dueber-dev/SIMON-Sistema-de-Monitoreo-Neuronal/cad/caja_pcb/README.md

# Caja de la PCB de SIMON

Caja con tapa para la PCB, en SolidWorks 2025 (piezas nativas con árbol y cotas). Pensada
para imprimirse en una **Flashforge Adventurer 5M con boquilla de 0.4 mm**, sin soportes.

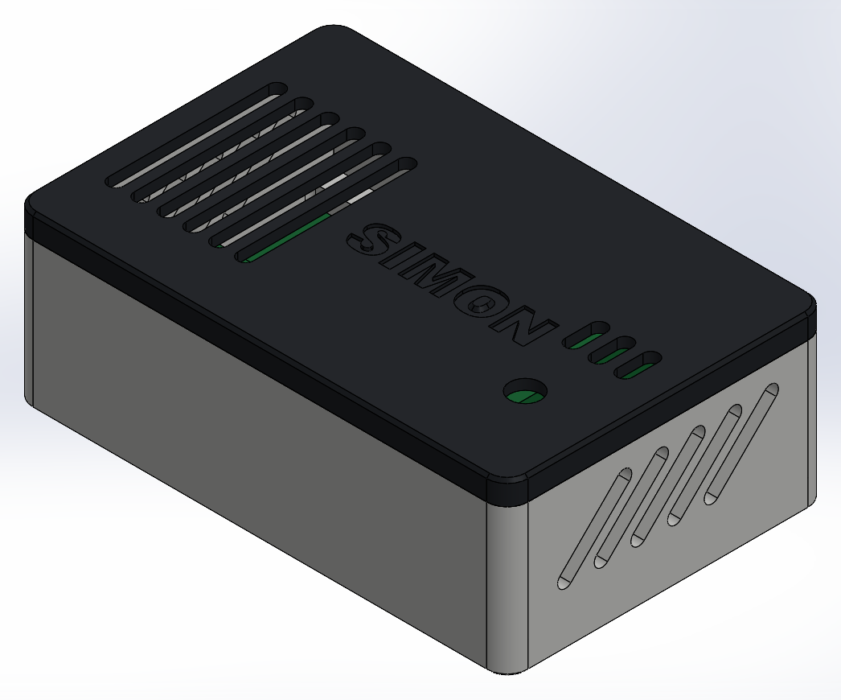
[picture p14: cad/caja_pcb/capturas/ensamble_cerrado.png]
cerrada

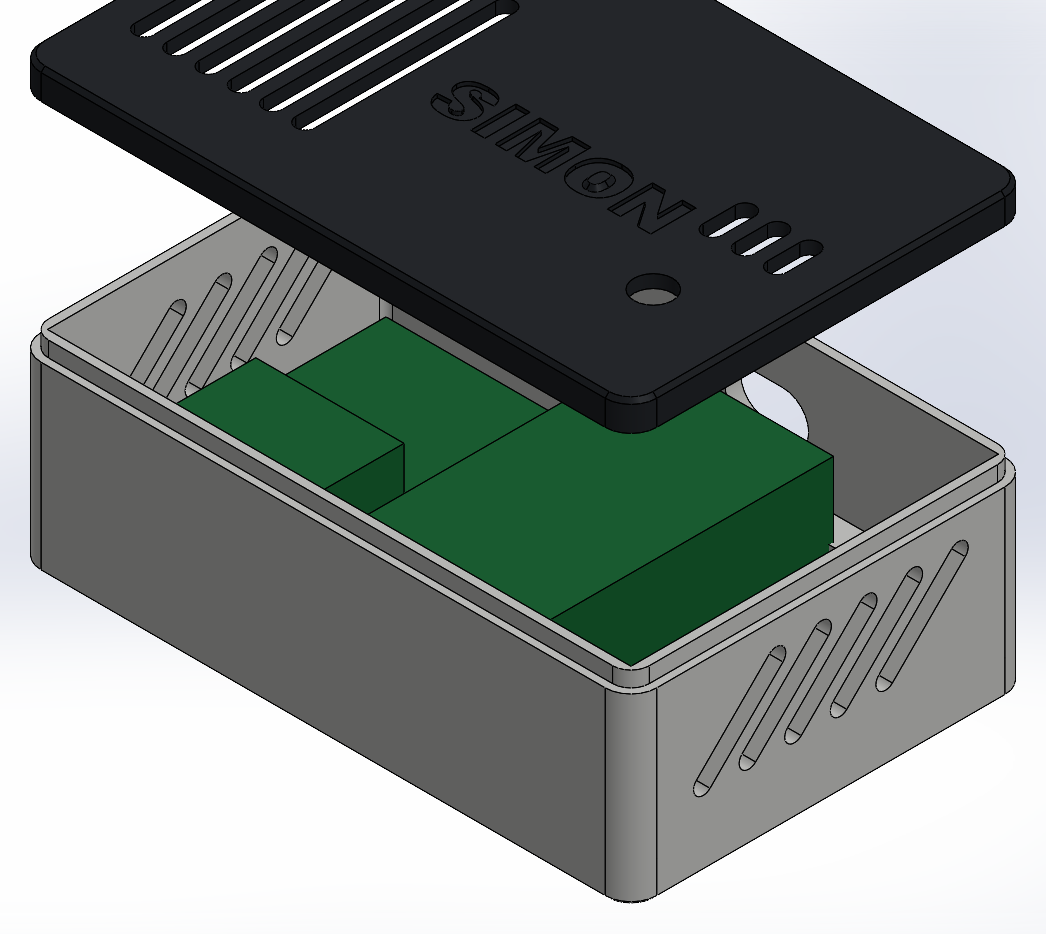
[picture p15: cad/caja_pcb/capturas/ensamble_abierto.png]
abierta


## Medidas

| | |
|---|---|
| Exterior | 95.5 × 62 × 33 mm (caja 30.9 + tapa) |
| Hueco de la PCB | **90.5 × 52.5 mm** (placa real + ~0.3 de tolerancia), hasta 2.5 mm sobre la PCB |
| Interior arriba | **90.5 × 57 mm**: el ESP32 sobresale por el lado del USB, así que los 4.5 mm de más van todos hacia la pared trasera (`ANCHO_ESP`) |
| Paredes | 2.5 mm |
| Piso y tapa | 2.0 mm (10 capas de 0.2; ahorra filamento sin perder rigidez) |
| PCB | apoyada 4 mm sobre el piso (las soldaduras van abajo) |
| Espacio sobre la PCB | 23.4 mm (el INA219 sobre su header mide ~20 mm) |
| Material | 43.6 cm³ macizo: caja 32.5 + tapa 11.1 (≈ 54 g de PLA si fuera 100 % lleno) |

## Cierre labio / escalón (lip/groove)

- **Caja:** la franja interior de la pared (1.35 mm, unas 3 líneas de 0.42) sube 2.4 mm sobre el borde. Es el **labio**.
- **Tapa:** su borde exterior (1.05 mm) baja 2.5 mm y abraza el labio. Es el **escalón**; por fuera queda al ras con la caja.
- **Holgura:** 0.1 mm por lado. Con 0.2 la primera impresión quedó un poco suelta, así que el labio creció 0.1 por lado. Si ahora queda muy duro, sube `HOLG_LG` (y baja `LABIO_W` lo mismo) en `caja_simon.py` y regenera.

La API de SolidWorks no permite crear la operación nativa *Lip/Groove*, así que está
modelada como dos operaciones con nombre: `Labio_lip` en la caja y `Escalon_groove` en la tapa.
Si prefieres la operación nativa de SolidWorks, usa la variante plana:

```bash
python caja_simon.py --plano
```

Genera `caja_simon_plano.SLDASM`: la tapa apoyada directo sobre la caja, sin labio, igual
que la primera caja. Ahí aplicas *Insertar → Operaciones de sujeción → Labio/Ranura*.

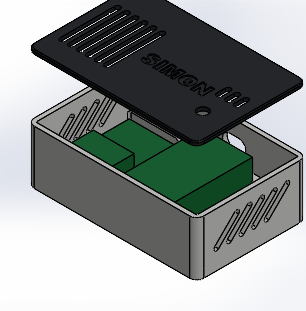
[picture p16: cad/caja_pcb/capturas/ensamble_abierto_plano.png]
plana


## Detalles de diseño

- **La PCB se ubica con las paredes**: no lleva agujeros. Descansa en 4 apoyos de esquina. La tapa no lleva postes, así que nada la aprieta desde arriba; si se mueve, fíjala a los apoyos con una gota de silicón caliente o cinta doble cara.
- **Alivios de Ø2 en las esquinas interiores:** la impresora redondea las esquinas y la placa, que es cuadrada, se trabaría. Con el alivio entra libre.
- **Pared trasera:** salida para el **USB del ESP32** y para el **cable del panel** (bornera J1). El frente queda limpio.
- **Ventilación:**
  - **Todas las ranuras (base y tapa) miden 3 mm de ancho**, así pasa un jumper dupont (2.54 mm) por ellas. Entre ranuras quedan 2 mm de material. Las dos medidas son `RANURA` y `NERVIO` en `caja_simon.py`.
  - **Rejilla diagonal en el piso:** 7 ranuras de 3 × 44 mm a 45°. El aire entra por abajo y sale por la tapa (efecto chimenea). Se imprimen como huecos en las primeras capas, sin soporte.
  - **5 ranuras diagonales de 3 × 19 mm a 45° en cada pared corta.** El borde de arriba de cada ranura queda a 45°, que la impresora hace sin soporte.
  - Ranuras en la tapa sobre las resistencias de carga y el INA219, que son lo que más calienta.
  - Tres ranuras junto al LM35.
  - Para que la rejilla del piso respire, pégale **4 patitas de hule** (bumpers de 2–3 mm) abajo. Si la caja queda pegada a la mesa, el piso casi no ventila.

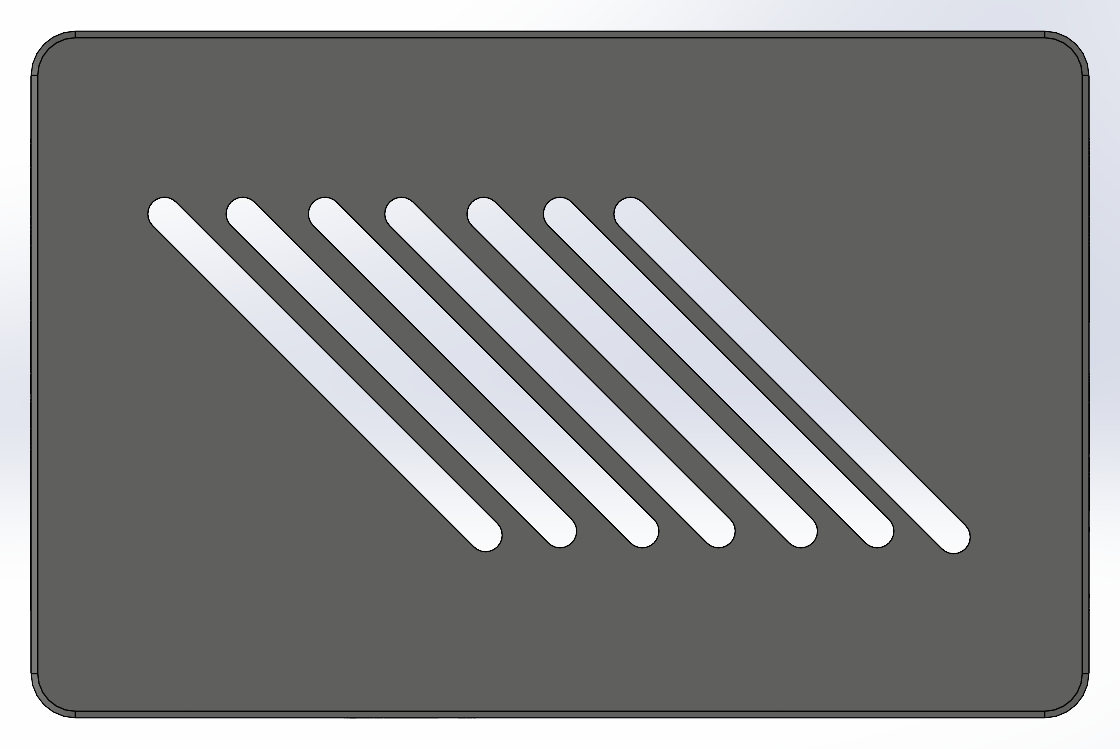
[picture p17: cad/caja_pcb/capturas/caja_simon_base_abajo.png]
piso
  
- **Ventana de Ø6 sobre la LDR:** sin ella, la LDR quedaría a oscuras dentro de la caja.
- **"SIMON" en bajo relieve** (0.6 mm) en la tapa. Como esa cara va contra la cama, sale nítido.
- **Chaflán de 0.6 mm** en los bordes que tocan la cama, contra la pata de elefante. No lleva redondeos abajo porque se imprimen mal.

## Imprimir (Flashforge Orca, perfil *Adventurer 5M 0.4 Nozzle*)

Los STL de `stl/` ya vienen orientados: caja con el piso abajo, tapa con su cara plana abajo
y el escalón hacia arriba. Solo hay que importarlos.

| Ajuste | Valor |
|---|---|
| Material | PLA (o PETG) |
| Altura de capa | 0.2 mm |
| Perímetros (wall loops) | 3: con 2.5 mm la pared sale maciza y el labio sale como perímetros |
| Capas superiores / inferiores | 4 / 4 |
| Relleno | 15 % giroide (solo afecta piso y tapa) |
| Soportes | ninguno |
| Costura (seam) | alineada atrás, para que quede en la pared del USB |
| Compensación pata de elefante | 0.1 mm |

El slicer dará los gramos exactos. Con estos ajustes debería quedar por debajo del valor macizo.

**Prueba de ajuste:** antes de imprimir todo, en Orca puedes cortar (*Cut*) los 5 mm superiores
de la caja e imprimirlos junto con la tapa, que solo mide 4.5 mm de alto. Así pruebas el labio rápido.

## Supuestos a confirmar

- **ESP32 montado sobre headers hembra de 8.5 mm.** De eso sale la altura de la salida USB. Si lo sueldan directo, la salida queda alta: ajusta `usb_y` en `caja_simon.py`.
- **Placa recortada con el diseño de 88 × 50 centrado** dentro de los 90.5 × 52.5. Las salidas tienen holgura (13 × 8 y 12 × 7) para absorber 1 mm de diferencia.

## Archivos

| Archivo | Qué es |
|---|---|
| `caja_simon.SLDASM` | Ensamble (caja + PCB de referencia + tapa) |
| `caja_simon_base.SLDPRT`, `caja_simon_tapa.SLDPRT` | Las piezas |
| `*_plano.*` | Variante sin labio, para el Lip/Groove nativo |
| `stl/` | Listos para el slicer |
| `caja_simon.STEP` | Para abrir en otro CAD |
| `caja_simon.py` | Medidas y construcción; se regenera con `python caja_simon.py` |
