dueber-dev/SIMON-Sistema-de-Monitoreo-Neuronal/design/index.html

# Buenos días, equipo SIMON ☀️

Panel solar · Sesión v7 · --:--:--

—

1 min 5 min 15 min Todo

## Cámara de inspección visual (ESP32-CAM) i

Soporte frontal a 50° En vivo http://192.168.4.2:81/stream

Actualizar foto

Conectando a ESP32-CAM…

Esperando señal de video o foto desde la cámara

## Potencia medida vs teórica i

MedidaTeórica (ficha técnica)mW · últimos 5 min

Medida / teórica —

Sesión en curso Energía generada en la sesión i

0,00Wh

00:00:00Tiempo activo

—Pico de potencia (mW)

## Eficiencia real vs nominal i

RealNominalUmbral de mantenimiento

Real — %

## Temperatura del panel i

°CUmbral de alerta

## Voltaje i

V · bus del INA219

## Corriente i

mA · INA219

## Potencia vs irradiancia i

mW vs W/m² · cada punto = 1 s · ajuste cuadrático

### Panel monocristalino

Prototipo · laboratorio

1,0 WNominal

9,1 %η nominal

110cm² área

#### Rendimiento vs nominal i

—

## Estado del sistema

i

## Sesiones

Ver todas

## Eficiencia predicha i

Modelo de demostración

— %

Calculando…

Ver predicción

### Fondo

Campo solar Atardecer Noche + Tu imagen

Desenfoque 0 px

Atenuar fondo 10 %
