dueber-dev/SIMON-Sistema-de-Monitoreo-Neuronal/design/maqueta-en-vivo.html

# Buenos días, equipo SIMON ☀️

Panel solar de prueba · Sesión v7 · --:--:--

ESP32 conectado · 1 Hz · 192.168.4.1

1 min 5 min 15 min Todo

## Potencia en vivo

mW · últimos 5 min

Pico — mW

Sesión en curso Energía generada en la sesión

0.00Wh

00:00:00Tiempo activo

0Muestras guardadas

## Voltaje

V · bus del INA219

## Corriente

mA · INA219

## Potencia vs irradiancia

Cada punto = 1 s · ajuste lineal

### Panel monocristalino

Prototipo · laboratorio

1.0 WNominal

6.0 VVoc

110cm² área

#### Rendimiento actual

Potencia instantánea respecto a la nominal (1.0 W)

## Estado del sistema

## Sesiones

Ver todas

- datos_panel_v7.csvHoy · en cursoEn vivo
- datos_panel_v6.csvAyer · 42 min · 2 518 muestras3.1 Wh
- datos_panel_v5.csv3 oct · 1 h 05 min · 3 912 muestras4.6 Wh

## Eficiencia predicha

Modelo de machine learning

— %

Modelo no cargado. Cuando esté entrenado, aquí se compara la eficiencia esperada con la real.

Conectar modelo (siguiente fase)

### Fondo

Campo solar Atardecer Noche + Tu imagen

Desenfoque 0 px

Atenuar fondo 10 %
