dueber-dev/SIMON-Sistema-de-Monitoreo-Neuronal/cad/caja_pcb/capturas/caja_simon_tapa.png

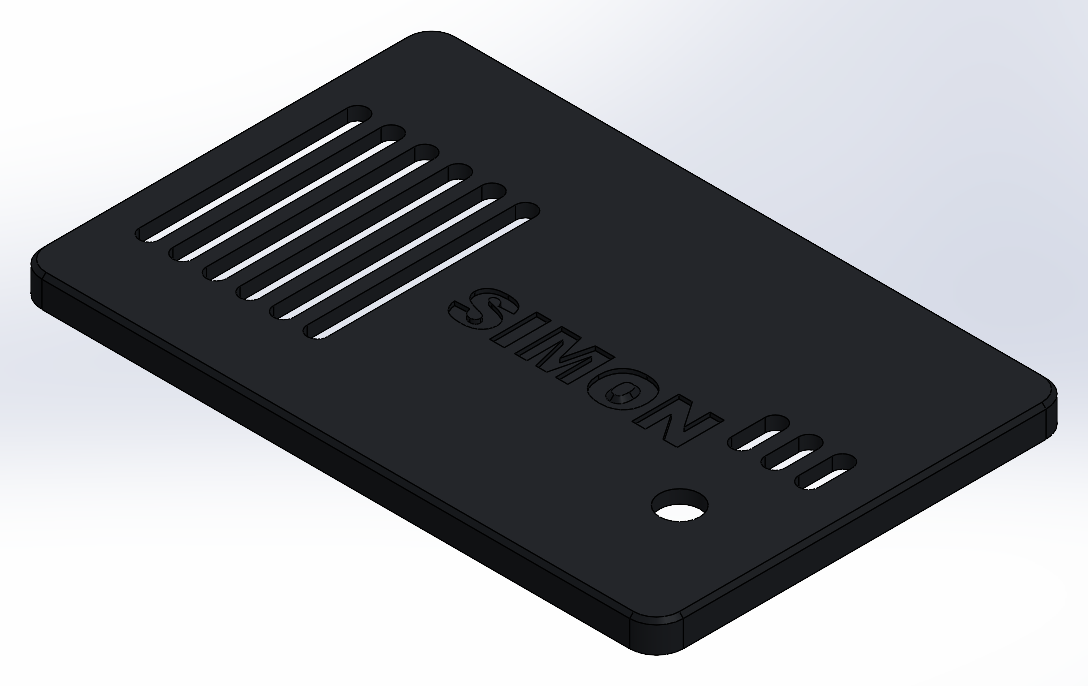
cad/caja_pcb/capturas/caja_simon_tapa.png
