dueber-dev/SIMON-Sistema-de-Monitoreo-Neuronal/cad/capturas/base_webcam.png

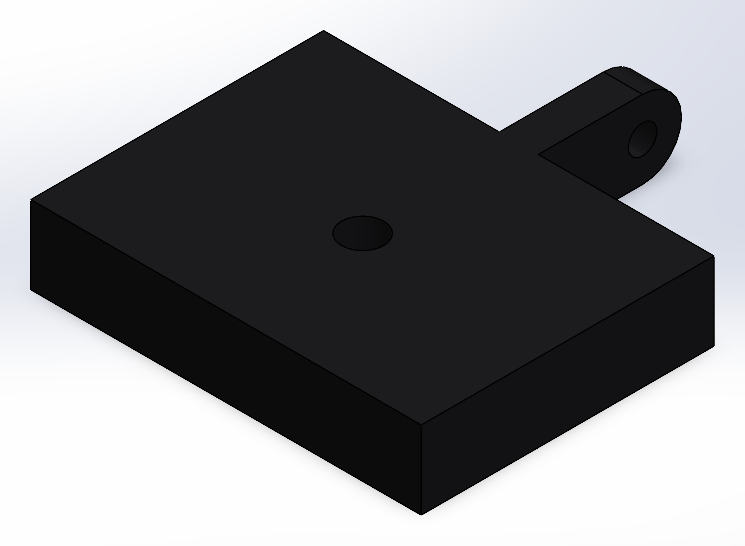
cad/capturas/base_webcam.png
