dueber-dev/SIMON-Sistema-de-Monitoreo-Neuronal/cad/capturas/base_y_torres.png

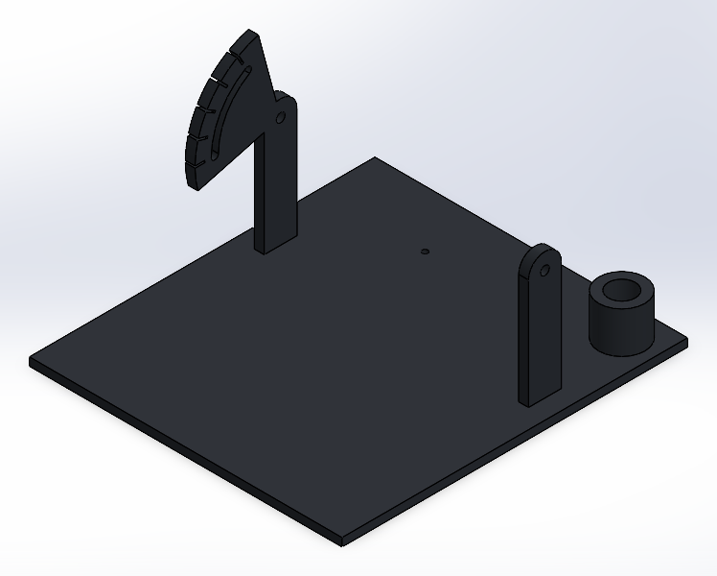
cad/capturas/base_y_torres.png
