dueber-dev/SIMON-Sistema-de-Monitoreo-Neuronal/cad/capturas/brazo_camara.png

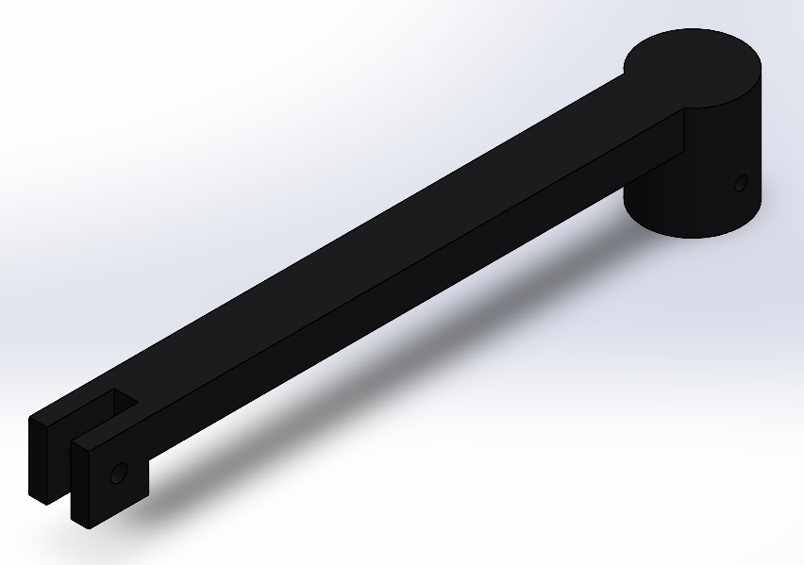
cad/capturas/brazo_camara.png
