dueber-dev/SIMON-Sistema-de-Monitoreo-Neuronal/cad/capturas/caja_pcb.png

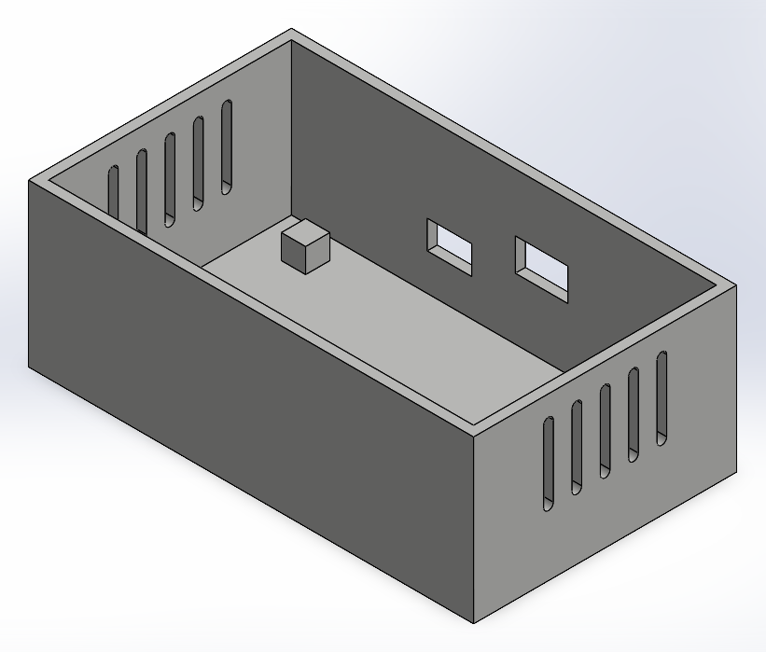
cad/capturas/caja_pcb.png
