dueber-dev/SIMON-Sistema-de-Monitoreo-Neuronal/cad/capturas/marco_panel.png

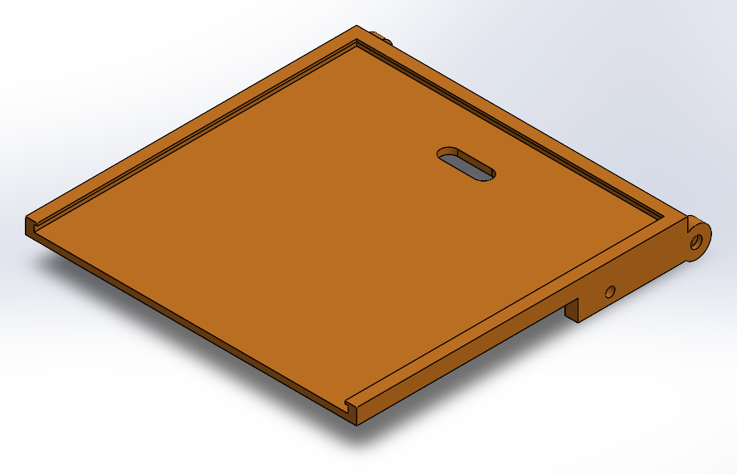
cad/capturas/marco_panel.png
