dueber-dev/SIMON-Sistema-de-Monitoreo-Neuronal/cad/capturas/perilla_M4.png

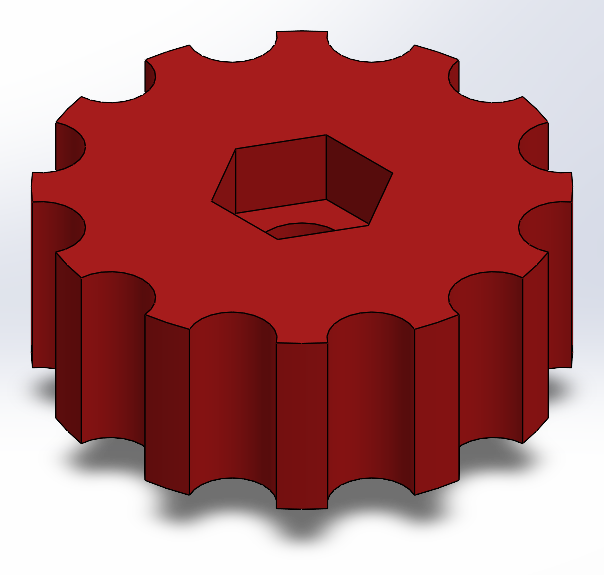
cad/capturas/perilla_M4.png
