dueber-dev/SIMON-Sistema-de-Monitoreo-Neuronal/cad/capturas/ref_panel_solar.png

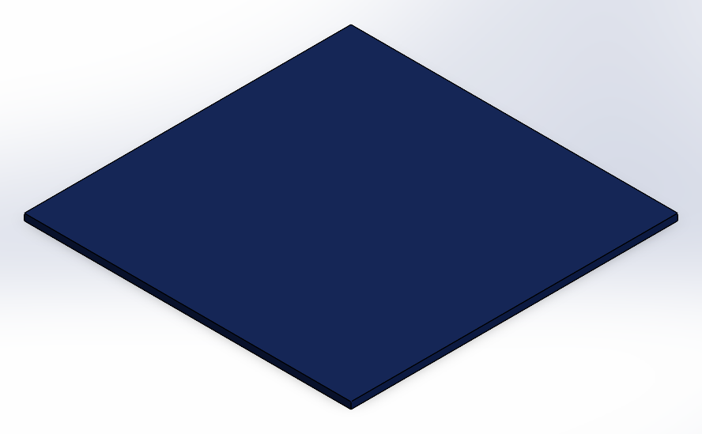
cad/capturas/ref_panel_solar.png
