dueber-dev/SIMON-Sistema-de-Monitoreo-Neuronal/cad/capturas/ref_pcb_simon.png

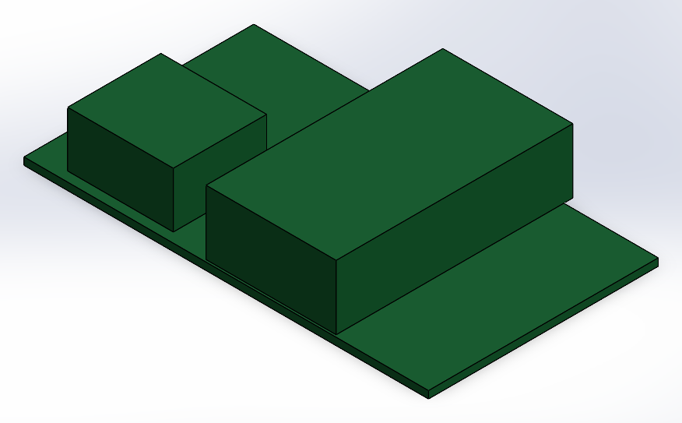
cad/capturas/ref_pcb_simon.png
