dueber-dev/SIMON-Sistema-de-Monitoreo-Neuronal/cad/capturas/tapa_caja.png

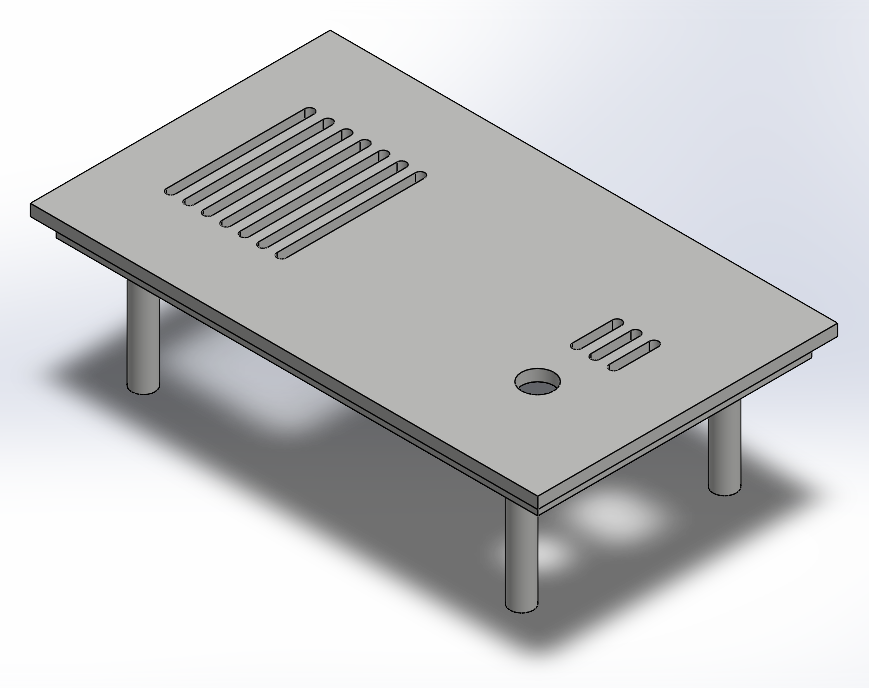
cad/capturas/tapa_caja.png
