dueber-dev/SIMON-Sistema-de-Monitoreo-Neuronal/cad/modulo_panel/capturas/camara_frente.png

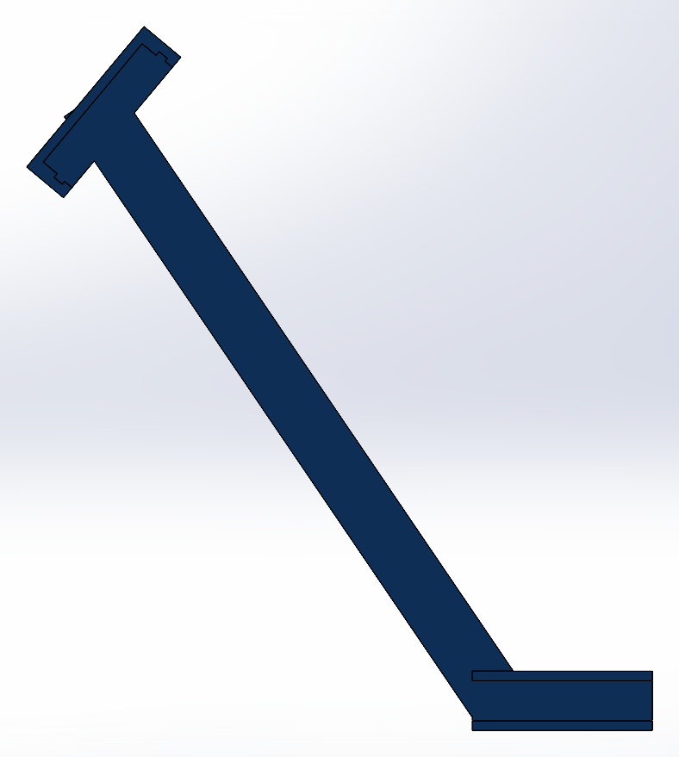
cad/modulo_panel/capturas/camara_frente.png
