dueber-dev/SIMON-Sistema-de-Monitoreo-Neuronal/cad/modulo_panel/capturas/camara_iso.png

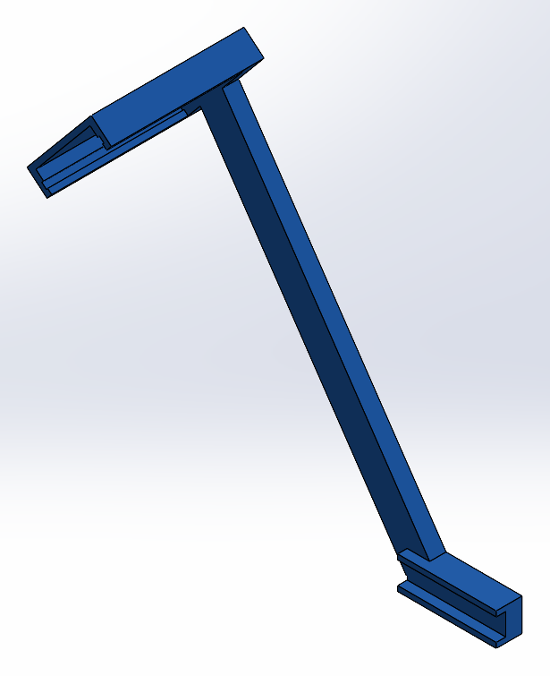
cad/modulo_panel/capturas/camara_iso.png
