dueber-dev/SIMON-Sistema-de-Monitoreo-Neuronal/cad/modulo_panel/capturas/camara_modulo_lado.png

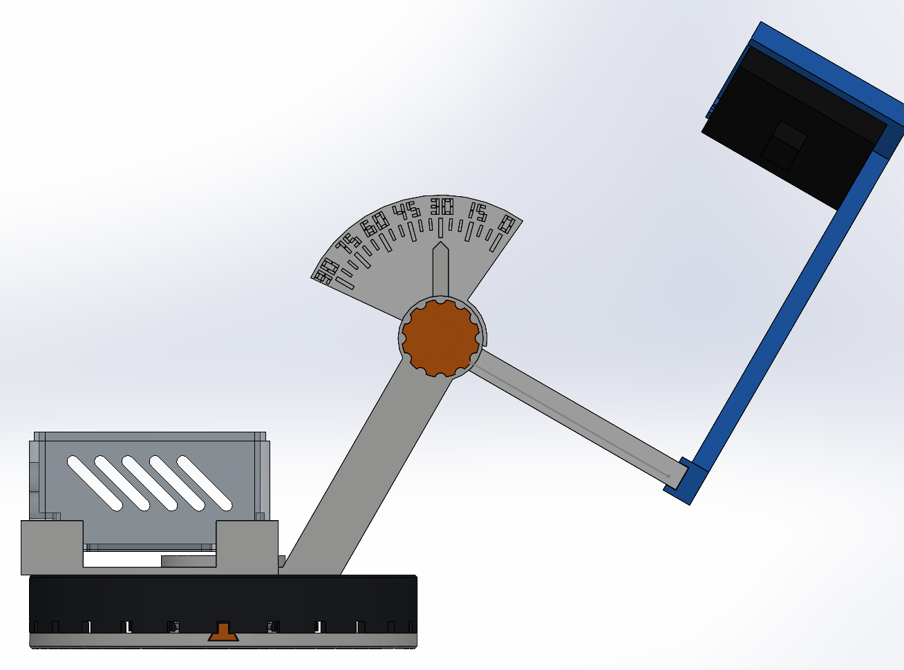
cad/modulo_panel/capturas/camara_modulo_lado.png
