dueber-dev/SIMON-Sistema-de-Monitoreo-Neuronal/cad/modulo_panel/capturas/marco_atras.png

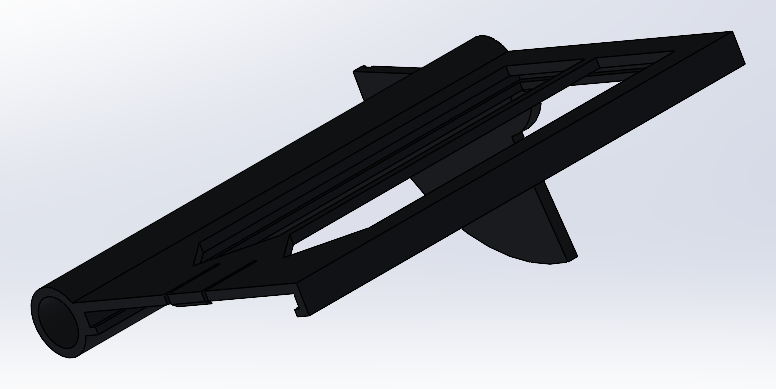
cad/modulo_panel/capturas/marco_atras.png
