dueber-dev/SIMON-Sistema-de-Monitoreo-Neuronal/cad/modulo_panel/capturas/modulo_sin_caja.png

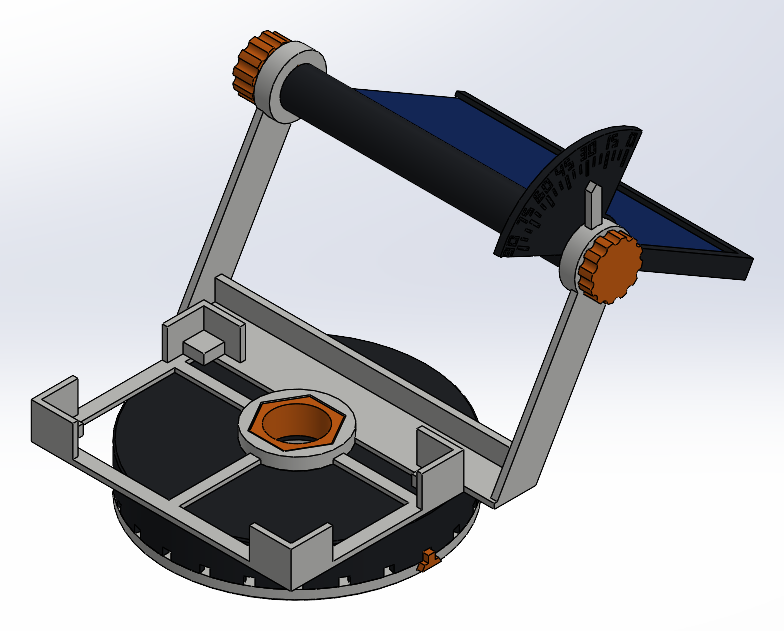
cad/modulo_panel/capturas/modulo_sin_caja.png
