dueber-dev/SIMON-Sistema-de-Monitoreo-Neuronal/cad/turntable/capturas/corte_frente.png

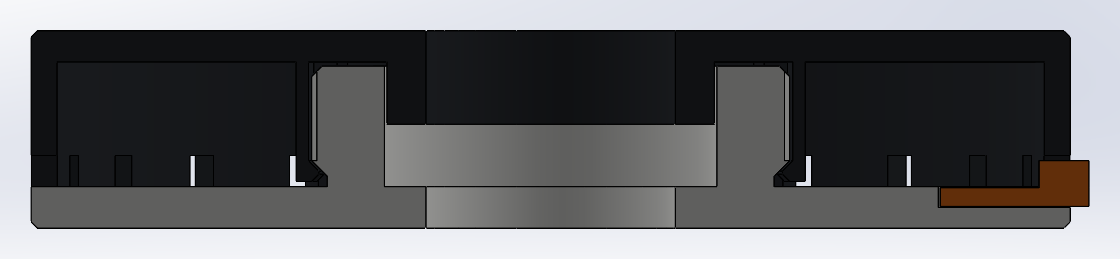
cad/turntable/capturas/corte_frente.png
