dueber-dev/SIMON-Sistema-de-Monitoreo-Neuronal/design/assets/fondo-campo-solar.webp

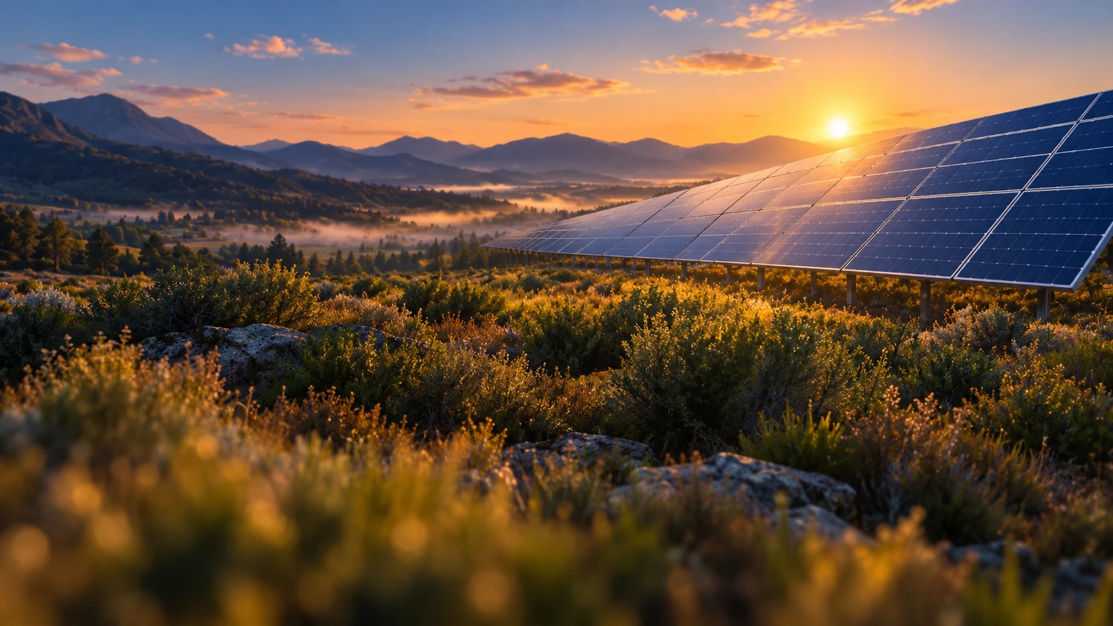
design/assets/fondo-campo-solar.webp
