dueber-dev/SIMON-Sistema-de-Monitoreo-Neuronal/entrega/capturas/01-en-vivo.webp

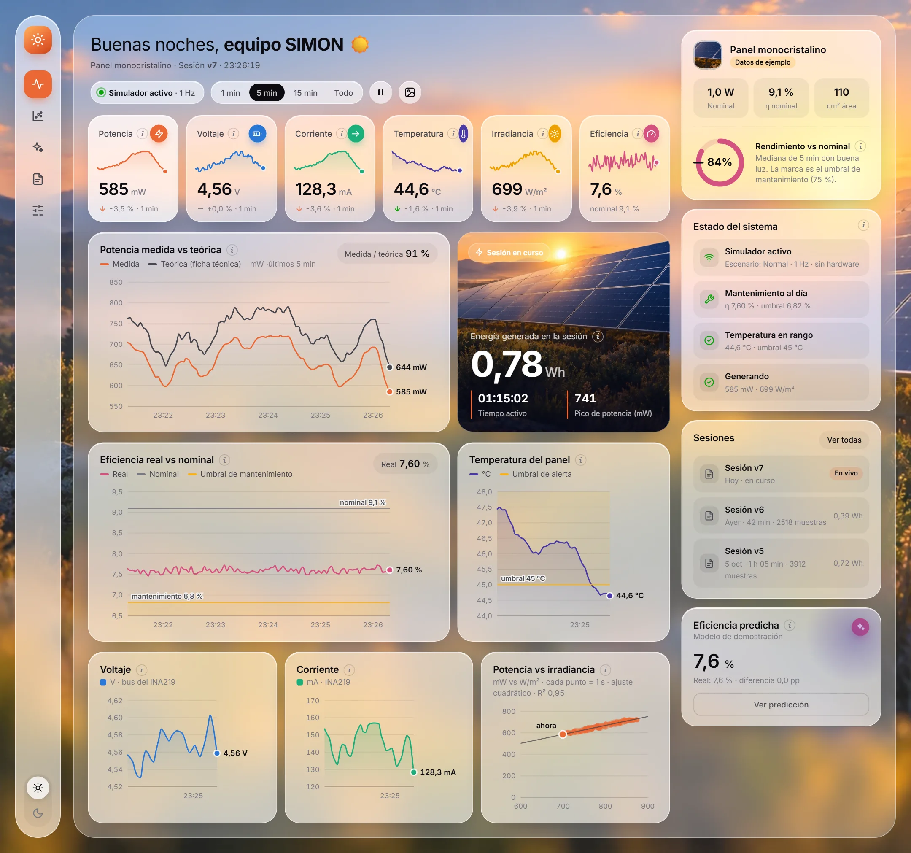
entrega/capturas/01-en-vivo.webp
