dueber-dev/SIMON-Sistema-de-Monitoreo-Neuronal/entrega/capturas/02-en-vivo-oscuro.webp

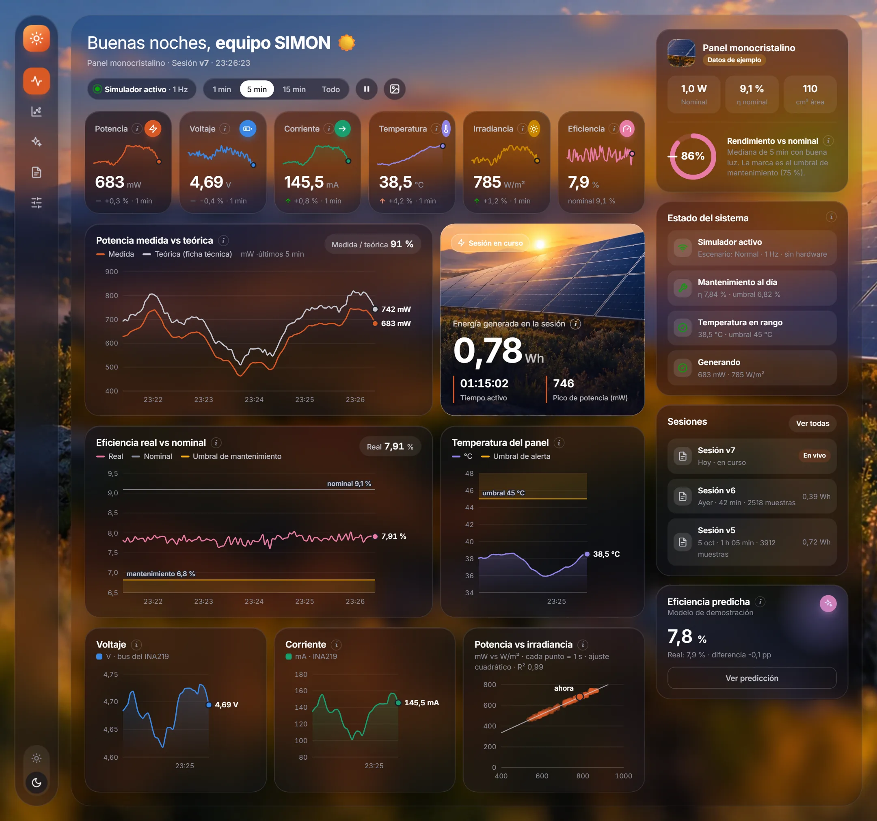
entrega/capturas/02-en-vivo-oscuro.webp
