dueber-dev/SIMON-Sistema-de-Monitoreo-Neuronal/entrega/capturas/03-justificacion.webp

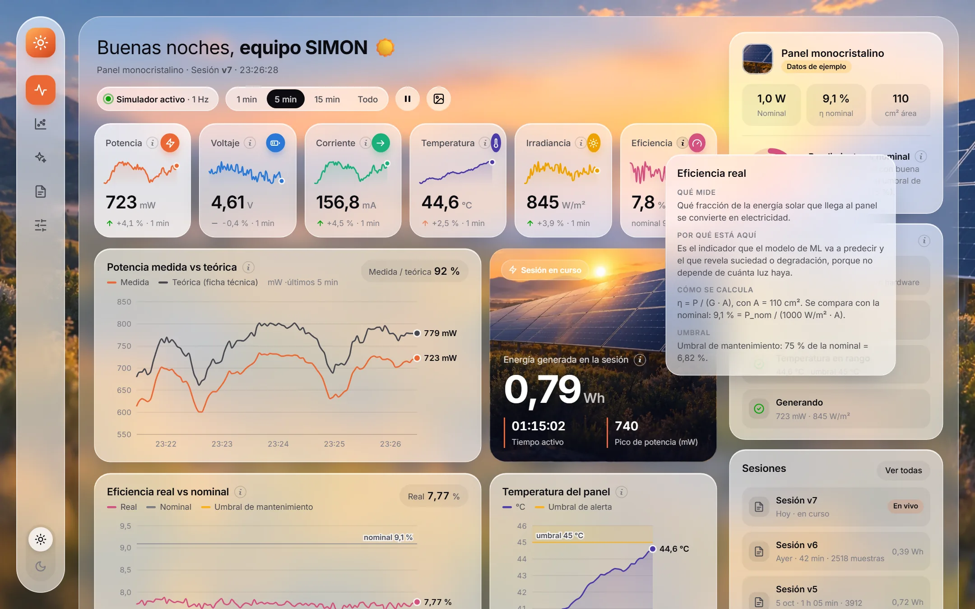
entrega/capturas/03-justificacion.webp
