dueber-dev/SIMON-Sistema-de-Monitoreo-Neuronal/entrega/capturas/04-alerta-mantenimiento.webp

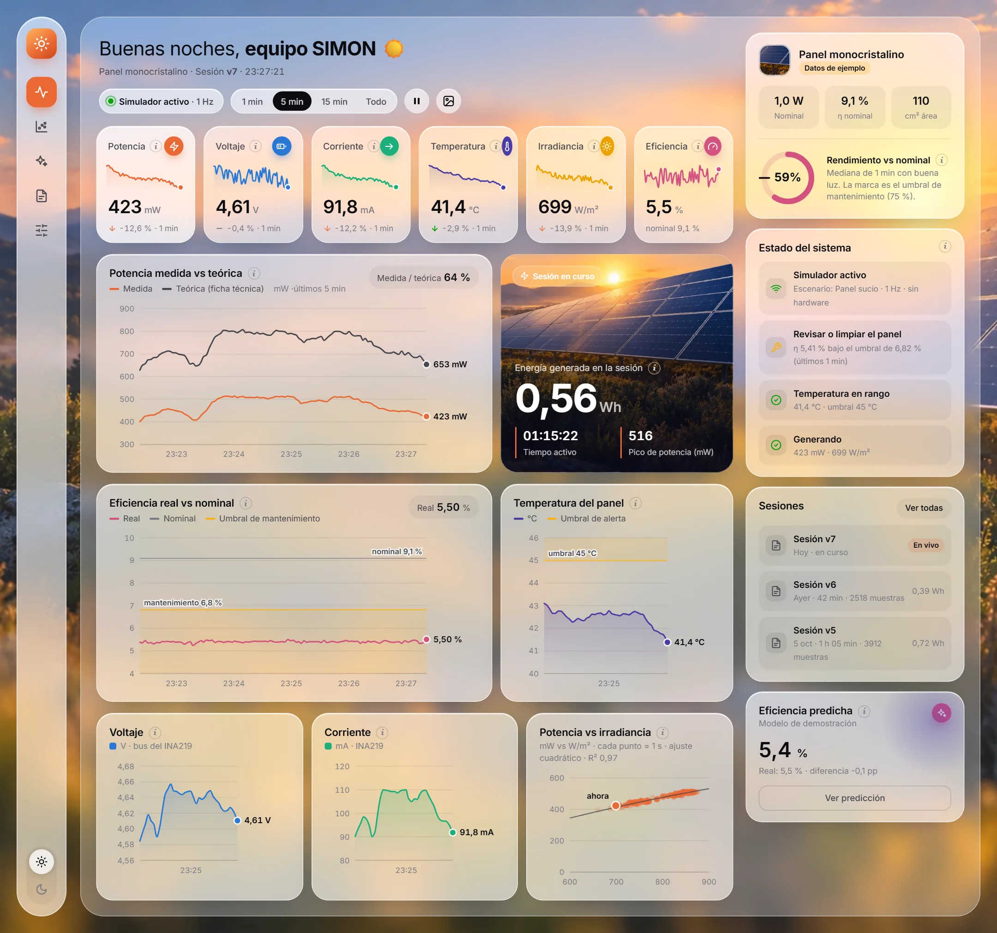
entrega/capturas/04-alerta-mantenimiento.webp
