dueber-dev/SIMON-Sistema-de-Monitoreo-Neuronal/entrega/capturas/05-analisis.webp

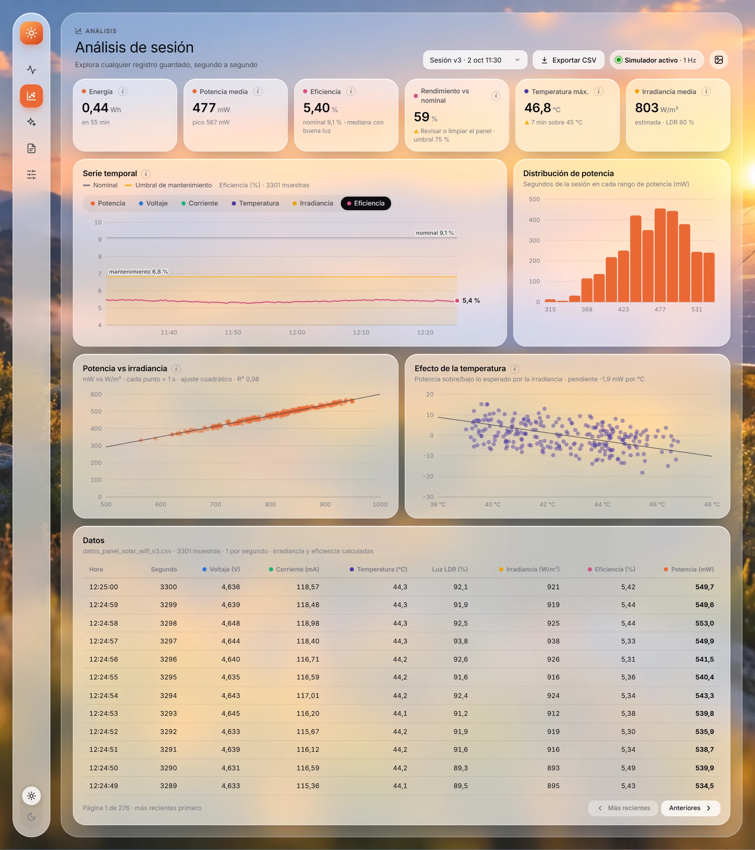
entrega/capturas/05-analisis.webp
