dueber-dev/SIMON-Sistema-de-Monitoreo-Neuronal/entrega/capturas/06-prediccion.webp

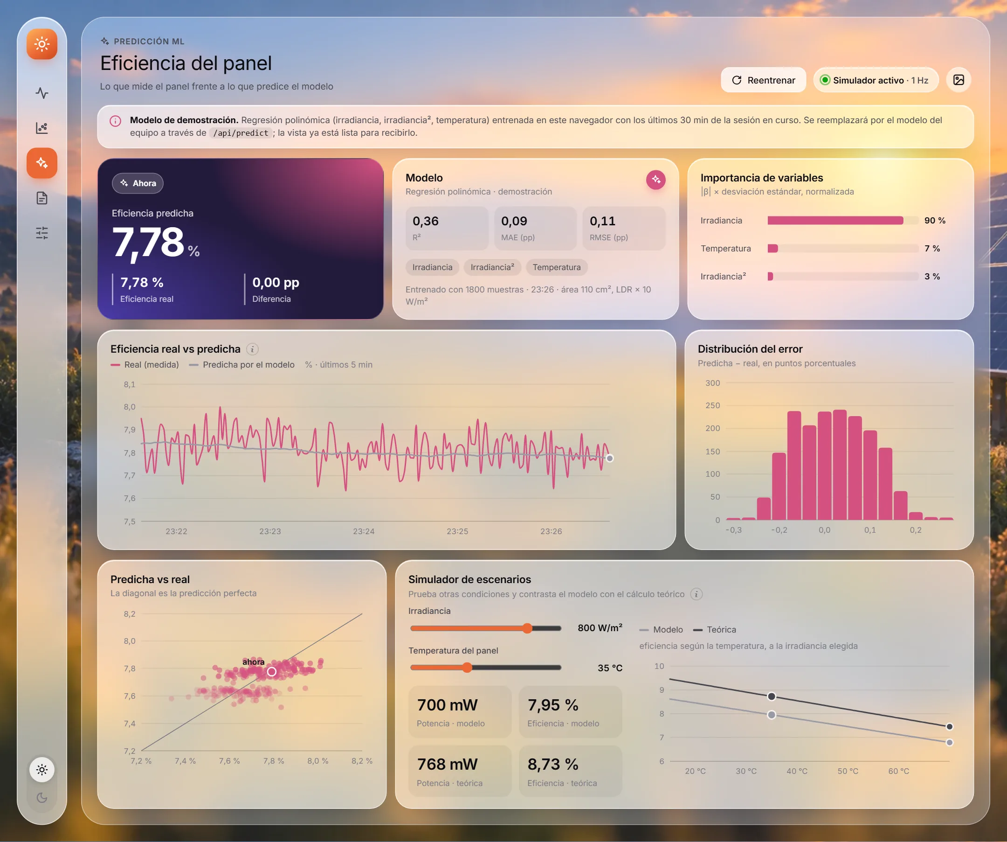
entrega/capturas/06-prediccion.webp
