dueber-dev/SIMON-Sistema-de-Monitoreo-Neuronal/entrega/capturas/07-sesiones.webp

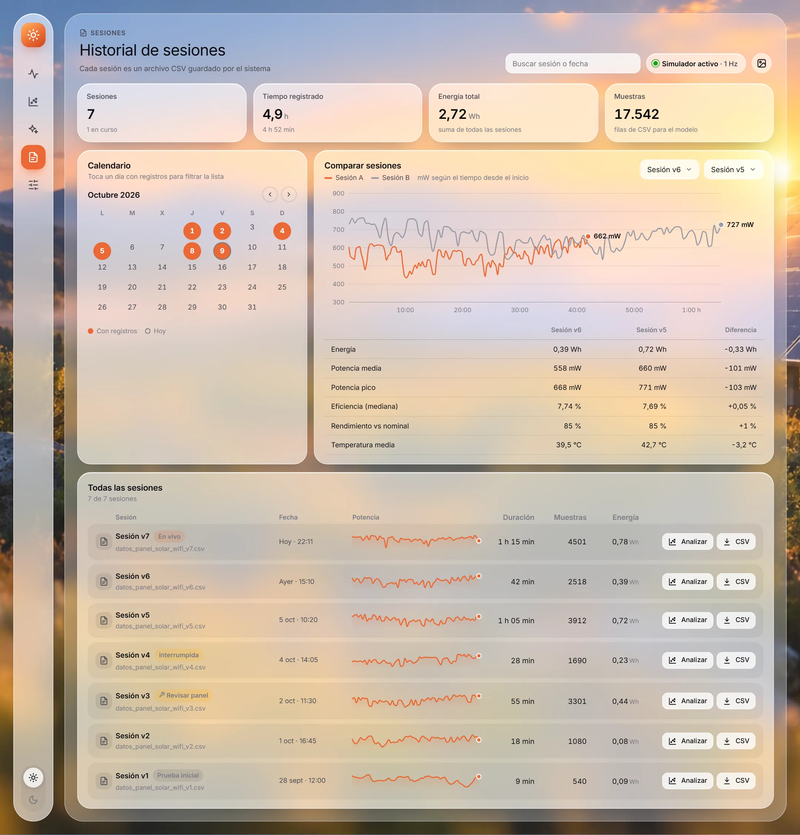
entrega/capturas/07-sesiones.webp
