dueber-dev/SIMON-Sistema-de-Monitoreo-Neuronal/entrega/capturas/08-configuracion.webp

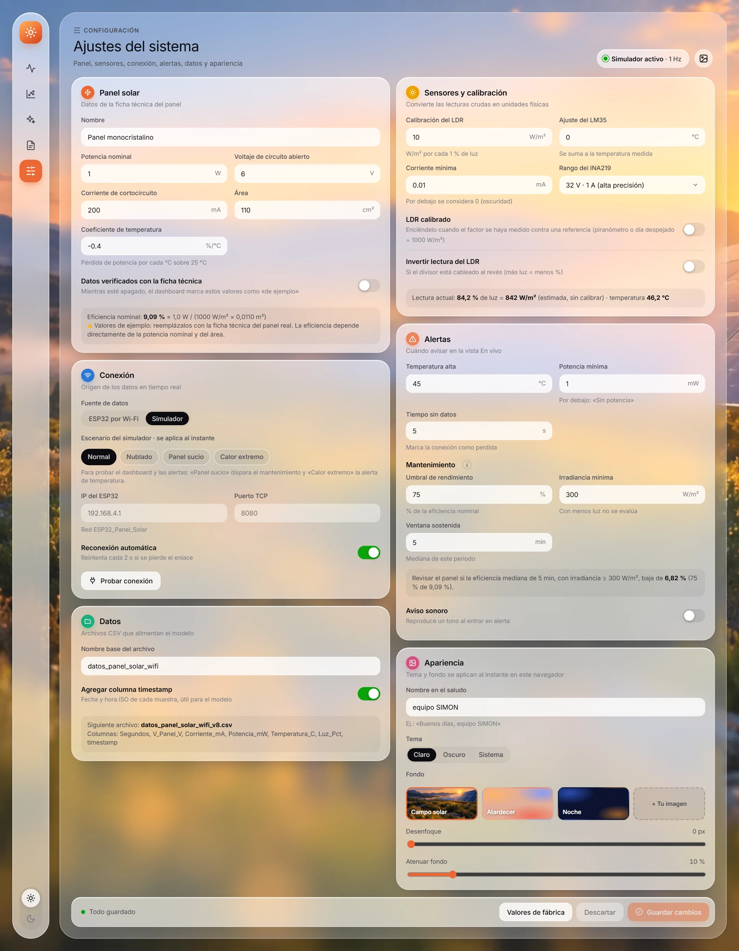
entrega/capturas/08-configuracion.webp
