dueber-dev/SIMON-Sistema-de-Monitoreo-Neuronal/entrega/capturas/09-fondo.webp

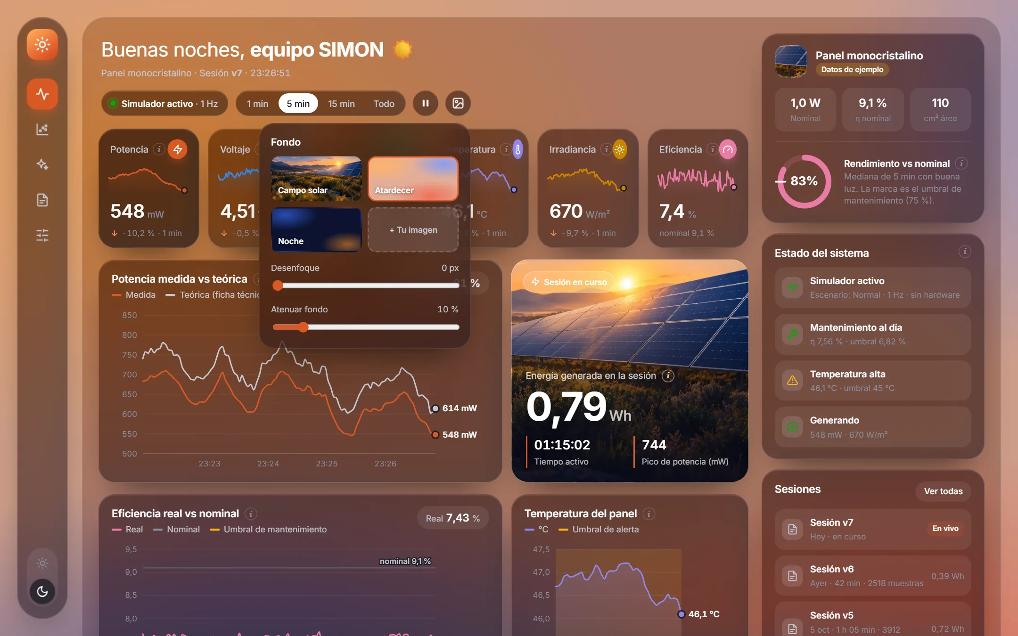
entrega/capturas/09-fondo.webp
