dueber-dev/SIMON-Sistema-de-Monitoreo-Neuronal/entrega/capturas/10-movil-en-vivo.webp

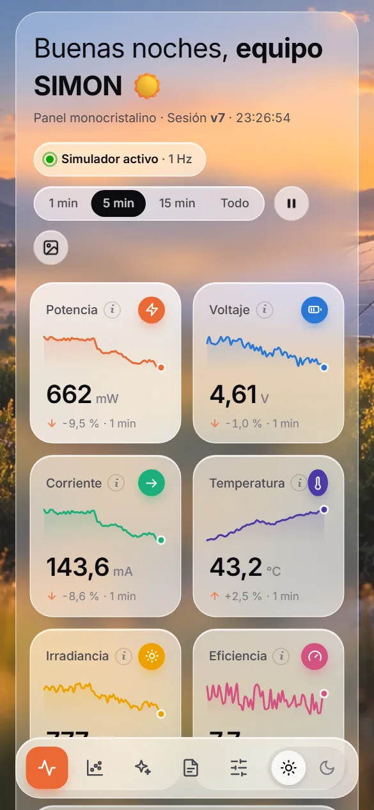
entrega/capturas/10-movil-en-vivo.webp
