dueber-dev/SIMON-Sistema-de-Monitoreo-Neuronal/entrega/capturas/11-movil-sesiones.webp

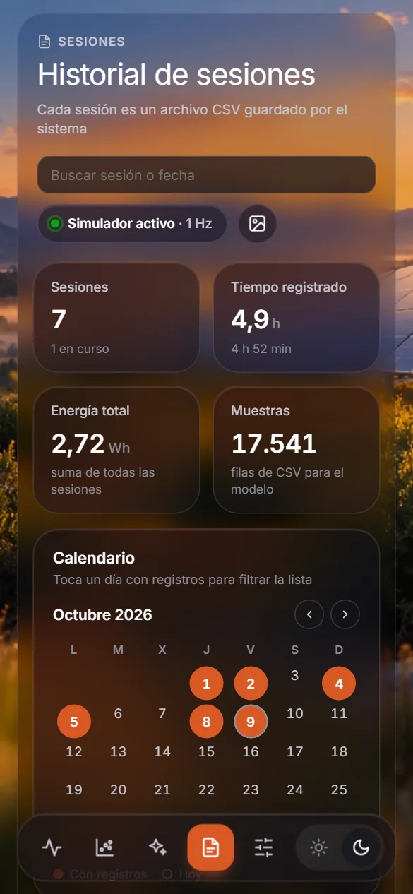
entrega/capturas/11-movil-sesiones.webp
