dueber-dev/SIMON-Sistema-de-Monitoreo-Neuronal/cad/caja_pcb/caja_simon_plano.SLDASM

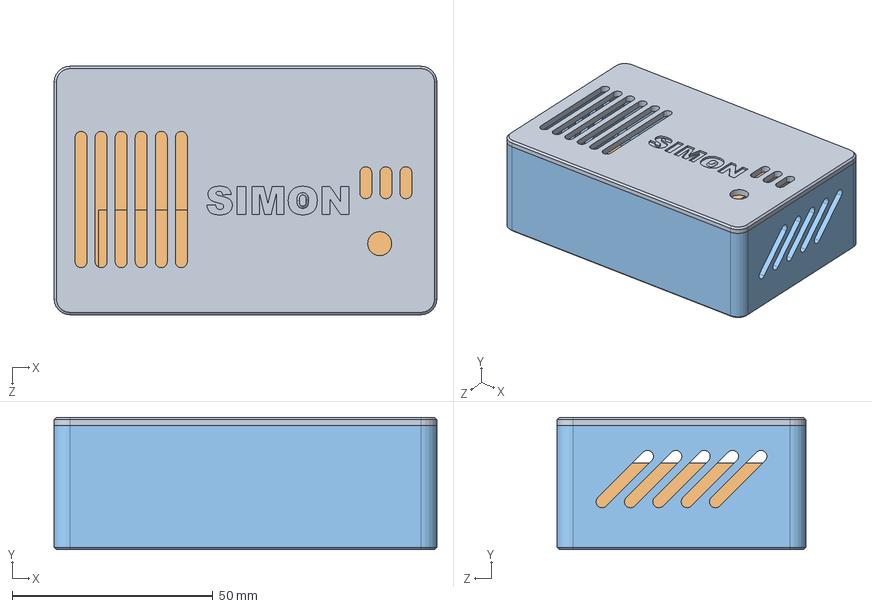
[picture p57: CAD file, 2026-10-27]
cad/caja_pcb/caja_simon_plano.SLDASM
95.5 x 33.0 x 62.0 mm
caja_simon_base_plano
ref_pcb_simon
caja_simon_tapa_plano
