dueber-dev/SIMON-Sistema-de-Monitoreo-Neuronal/cad/modulo_panel/modulo_panel.SLDPRT

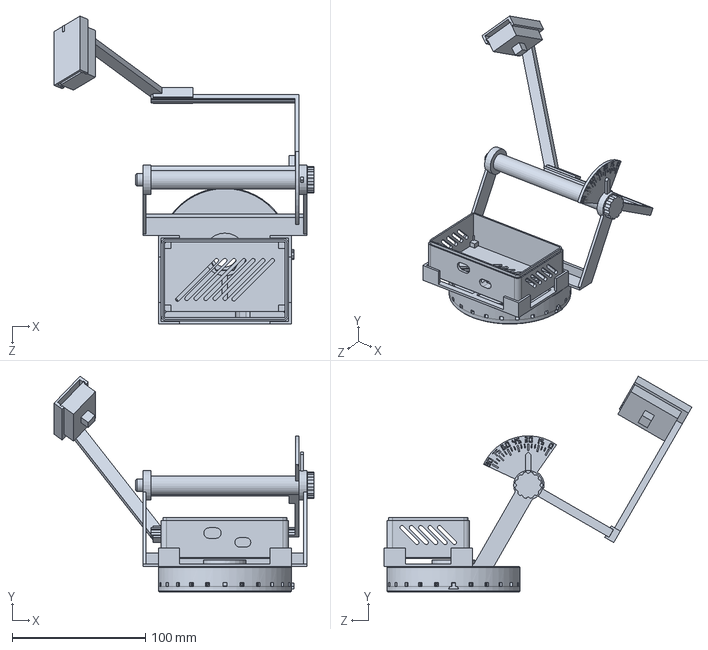
[picture p58: CAD file, 2026-11-05]
cad/modulo_panel/modulo_panel.SLDPRT
195.0 x 161.8 x 231.0 mm
