dueber-dev/SIMON-Sistema-de-Monitoreo-Neuronal/cad/modulo_panel/respaldo/modulo_panel_vergon_2026-11-05.SLDPRT

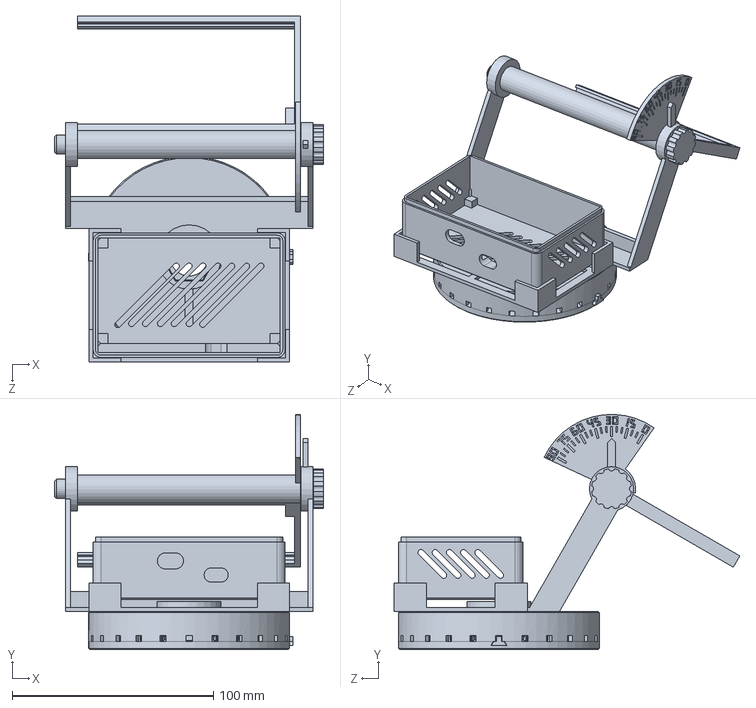
[picture p59: CAD file, 2026-11-05]
cad/modulo_panel/respaldo/modulo_panel_vergon_2026-11-05.SLDPRT
133.8 x 117.0 x 172.0 mm
