dueber-dev/SIMON-Sistema-de-Monitoreo-Neuronal/cad/modulo_panel/stl/modulo_panel_vergon.STL

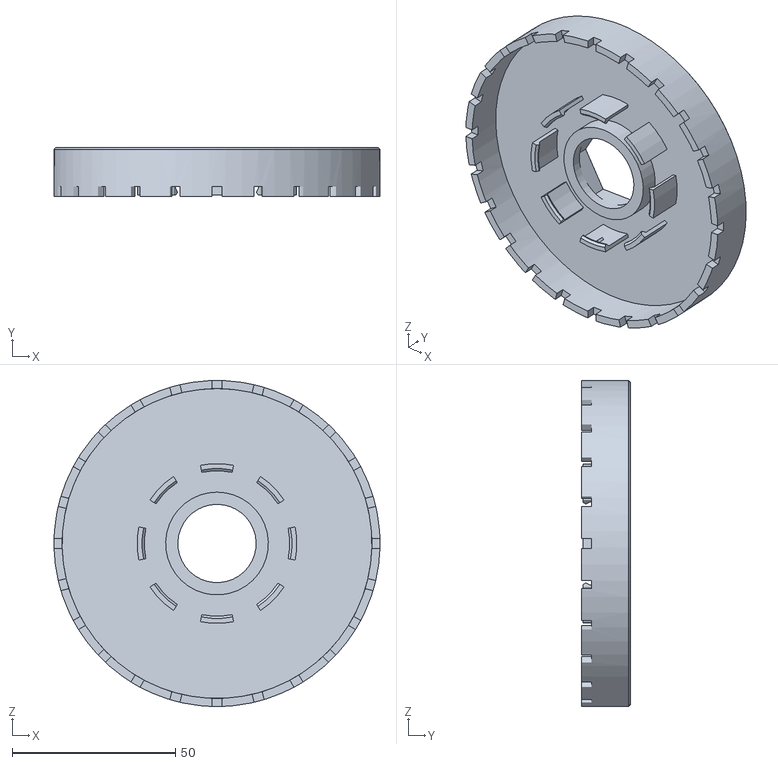
[picture p60: CAD file, 2026-11-05]
cad/modulo_panel/stl/modulo_panel_vergon.STL
100.0 x 15.0 x 100.0
