dueber-dev/SIMON-Sistema-de-Monitoreo-Neuronal/cad/SIMON_estacion.STEP

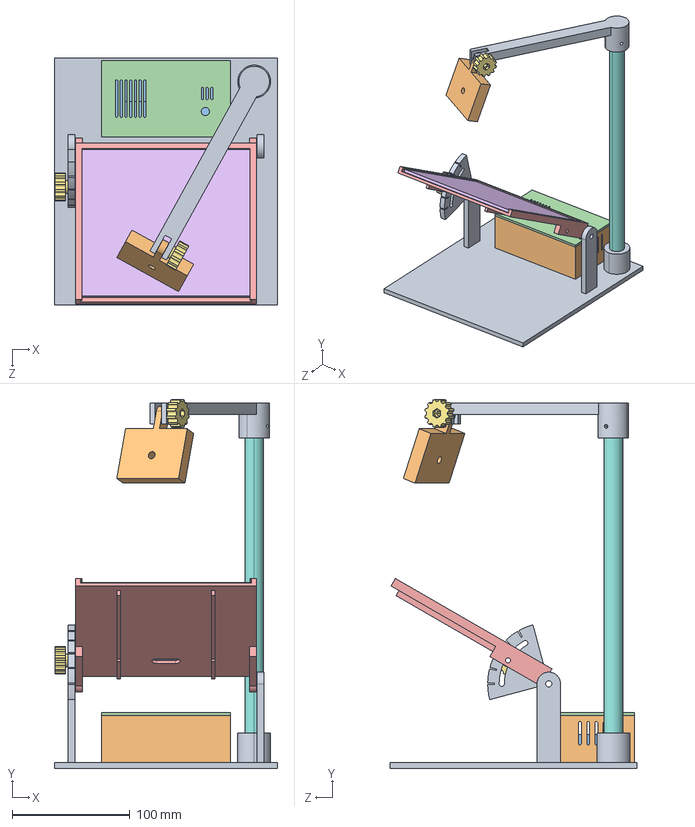
[picture p61: CAD file, 2026-10-27]
cad/SIMON_estacion.STEP
190.0 x 313.8 x 210.0 mm
base_y_torres
caja_pcb
ref_pcb_simon
tapa_caja
marco_panel
ref_panel_solar
perilla_M4 x 2
mastil_tubo
brazo_camara
base_webcam
