dueber-dev/SIMON-Sistema-de-Monitoreo-Neuronal/cad/solidworks/base_webcam.SLDPRT

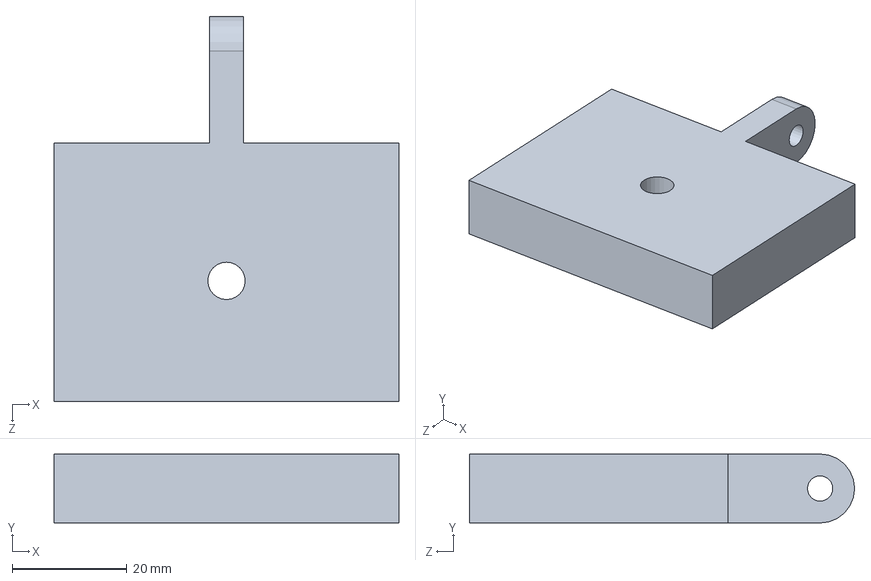
[picture p62: CAD file, 2026-10-27]
cad/solidworks/base_webcam.SLDPRT
60.0 x 12.0 x 67.0 mm
