dueber-dev/SIMON-Sistema-de-Monitoreo-Neuronal/cad/turntable/turntable_simon.SLDPRT

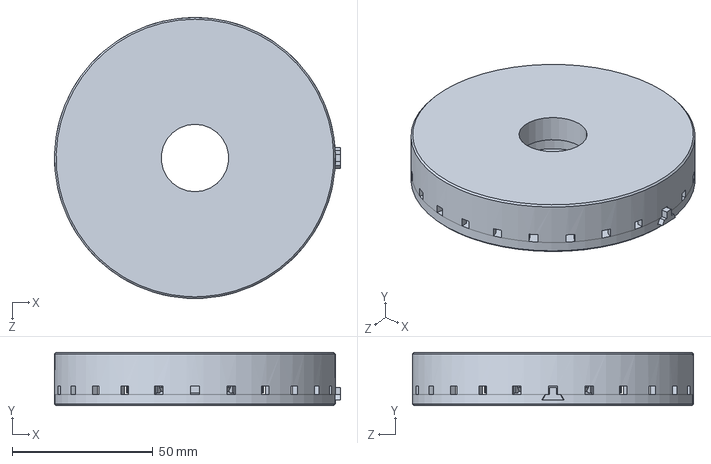
[picture p63: CAD file, 2026-10-27]
cad/turntable/turntable_simon.SLDPRT
101.8 x 19.0 x 100.0 mm
