dueber-dev/SIMON-Sistema-de-Monitoreo-Neuronal/cad/caja_pcb/caja_simon.STEP

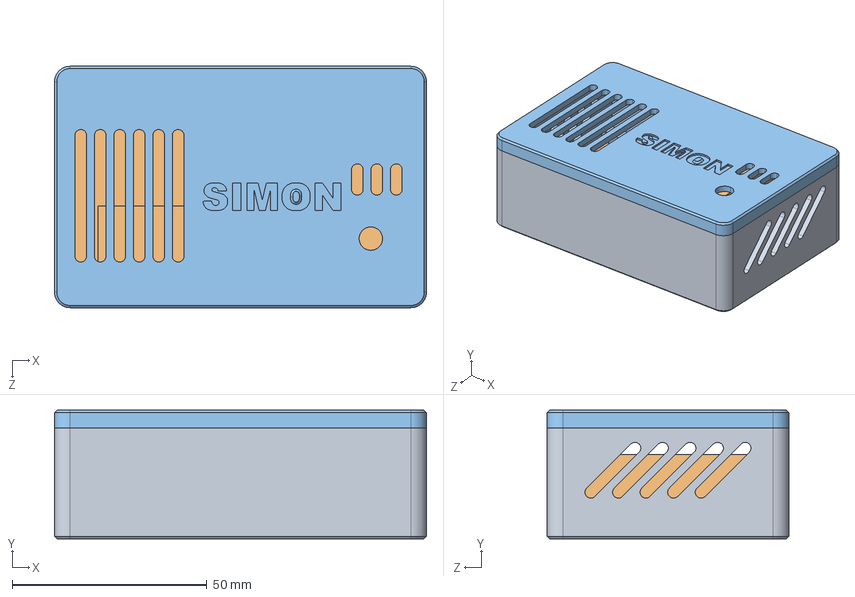
[picture p64: CAD file, 2026-10-27]
cad/caja_pcb/caja_simon.STEP
95.5 x 33.0 x 62.0 mm
caja_simon_base
ref_pcb_simon
caja_simon_tapa
