dueber-dev/SIMON-Sistema-de-Monitoreo-Neuronal/cad/modulo_panel/esp32cam_ref.SLDPRT

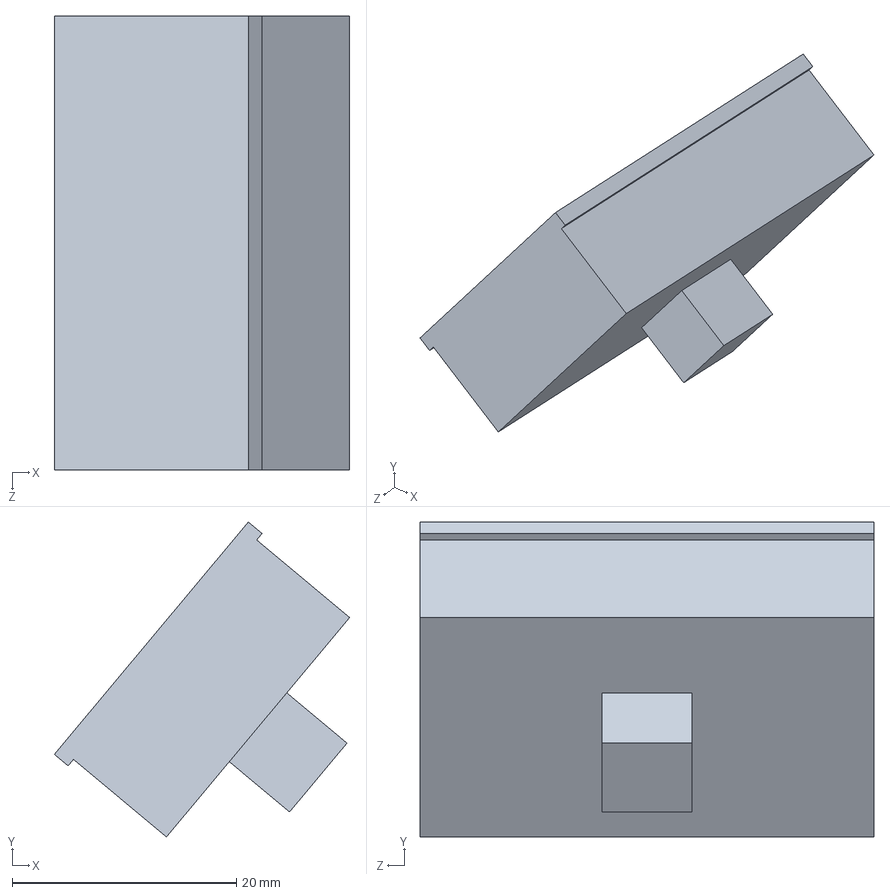
[picture p65: CAD file, 2026-11-05]
cad/modulo_panel/esp32cam_ref.SLDPRT
26.3 x 28.1 x 40.5 mm
