dueber-dev/SIMON-Sistema-de-Monitoreo-Neuronal/cad/modulo_panel/stl/seguro.STL

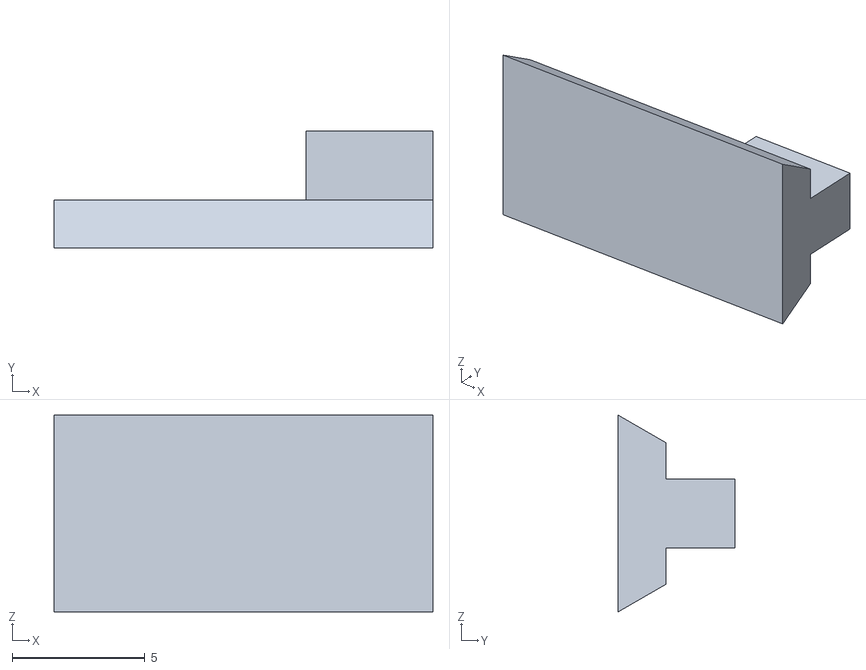
[picture p66: CAD file, 2026-11-05]
cad/modulo_panel/stl/seguro.STL
14.3 x 4.40 x 7.42
