dueber-dev/SIMON-Sistema-de-Monitoreo-Neuronal/cad/solidworks/ref_pcb_simon.SLDPRT

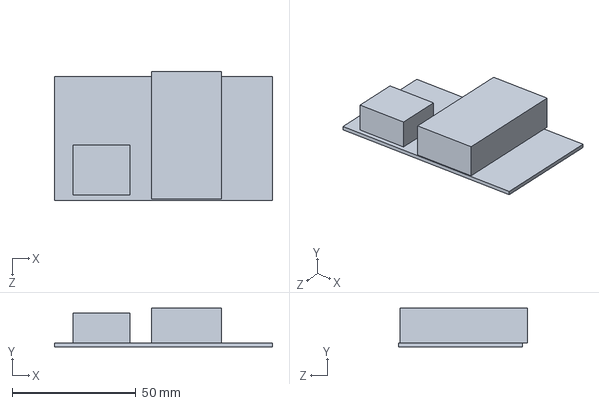
[picture p67: CAD file, 2026-10-27]
cad/solidworks/ref_pcb_simon.SLDPRT
88.0 x 15.6 x 52.0 mm
