dueber-dev/SIMON-Sistema-de-Monitoreo-Neuronal/cad/turntable/stl/turntable_base.STL

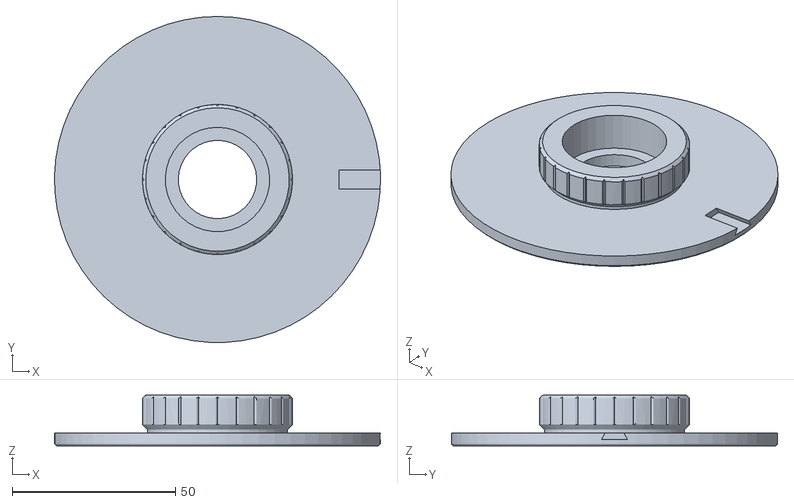
[picture p68: CAD file, 2026-10-27]
cad/turntable/stl/turntable_base.STL
100.0 x 100.0 x 15.6
