dueber-dev/SIMON-Sistema-de-Monitoreo-Neuronal/cad/caja_pcb/caja_simon_base.SLDPRT

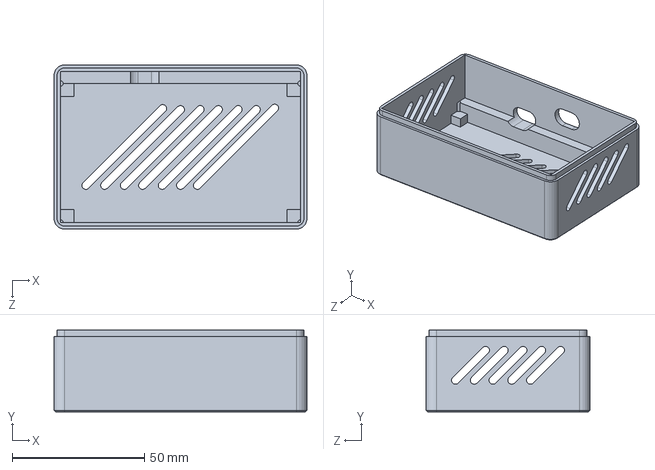
[picture p69: CAD file, 2026-10-27]
cad/caja_pcb/caja_simon_base.SLDPRT
95.5 x 30.9 x 62.0 mm
