dueber-dev/SIMON-Sistema-de-Monitoreo-Neuronal/cad/modulo_panel/camara_esp32.SLDPRT

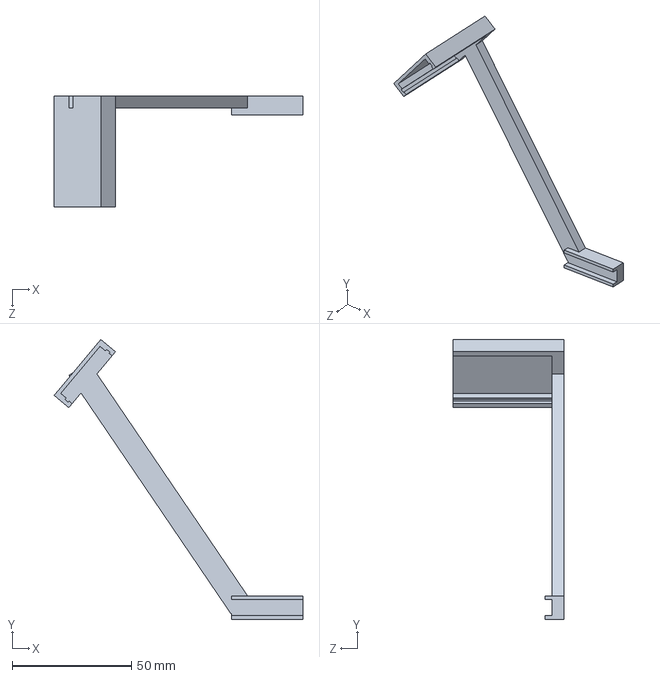
[picture p70: CAD file, 2026-11-05]
cad/modulo_panel/camara_esp32.SLDPRT
104.2 x 117.3 x 46.5 mm
