dueber-dev/SIMON-Sistema-de-Monitoreo-Neuronal/cad/modulo_panel/stl/marco_panel_vergon.STL

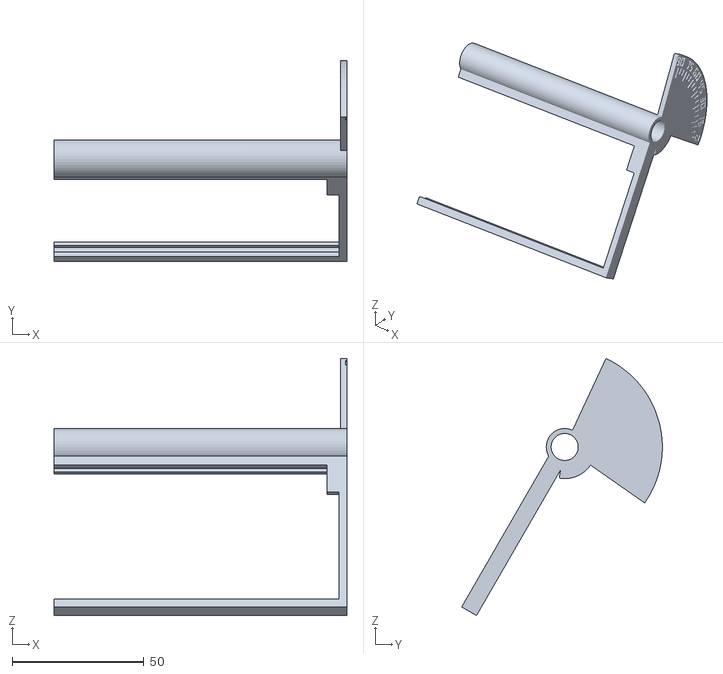
[picture p71: CAD file, 2026-11-05]
cad/modulo_panel/stl/marco_panel_vergon.STL
111.0 x 76.0 x 97.4
