dueber-dev/SIMON-Sistema-de-Monitoreo-Neuronal/cad/solidworks/brazo_camara.SLDPRT

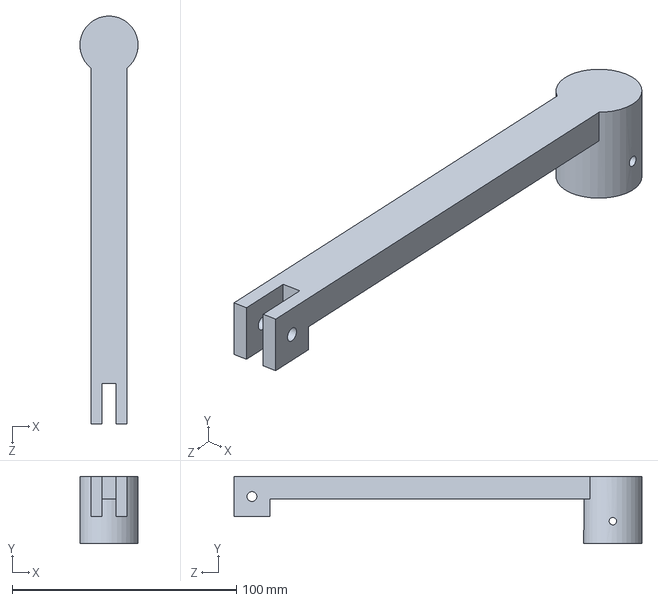
[picture p72: CAD file, 2026-10-27]
cad/solidworks/brazo_camara.SLDPRT
26.0 x 30.0 x 182.0 mm
