dueber-dev/SIMON-Sistema-de-Monitoreo-Neuronal/cad/modulo_panel/stl/marco_panel.STL

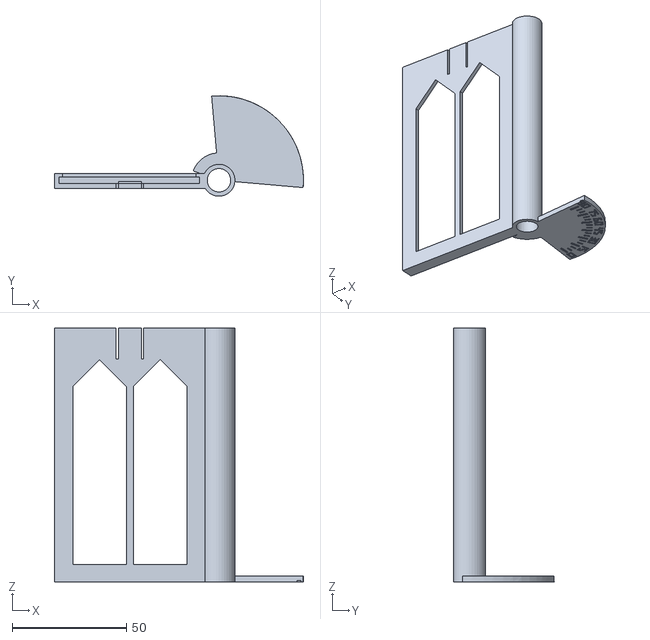
[picture p73: CAD file, 2026-10-27]
cad/modulo_panel/stl/marco_panel.STL
109.0 x 44.0 x 111.0
