dueber-dev/SIMON-Sistema-de-Monitoreo-Neuronal/cad/solidworks/caja_pcb.SLDPRT

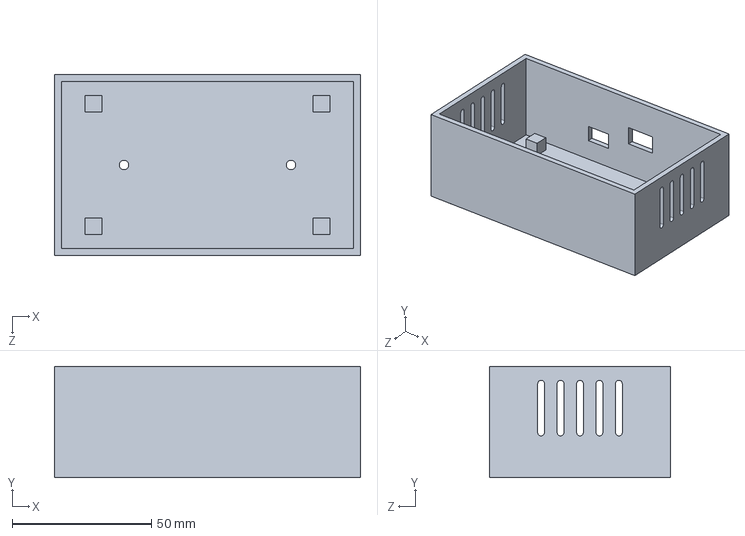
[picture p74: CAD file, 2026-10-27]
cad/solidworks/caja_pcb.SLDPRT
110.0 x 40.0 x 65.0 mm
