dueber-dev/SIMON-Sistema-de-Monitoreo-Neuronal/cad/caja_pcb/caja_simon_tapa.SLDPRT

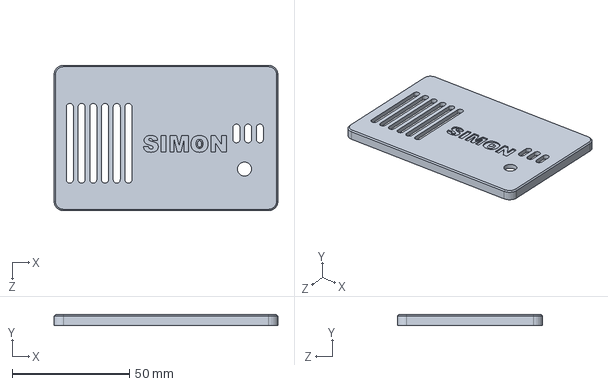
[picture p75: CAD file, 2026-10-27]
cad/caja_pcb/caja_simon_tapa.SLDPRT
95.5 x 4.50 x 62.0 mm
