dueber-dev/SIMON-Sistema-de-Monitoreo-Neuronal/cad/modulo_panel/stl/soporte.STL

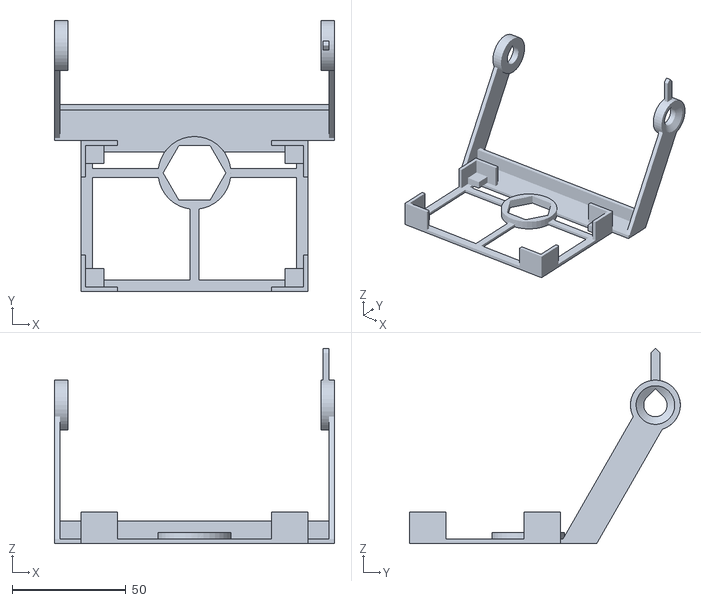
[picture p76: CAD file, 2026-10-27]
cad/modulo_panel/stl/soporte.STL
123.2 x 119.2 x 86.0
