dueber-dev/SIMON-Sistema-de-Monitoreo-Neuronal/cad/solidworks/base_y_torres.SLDPRT

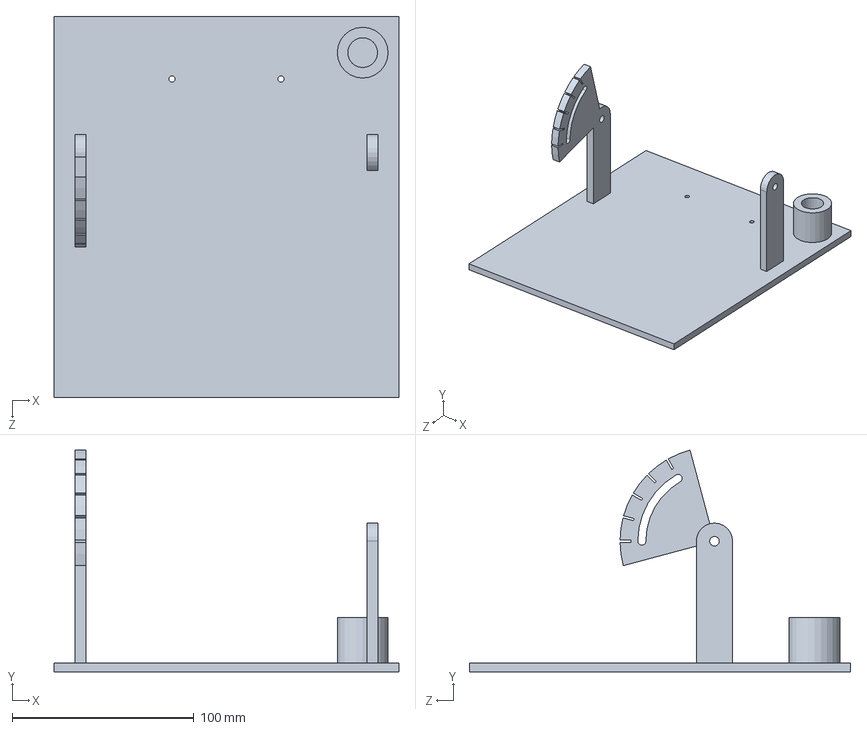
[picture p77: CAD file, 2026-10-27]
cad/solidworks/base_y_torres.SLDPRT
190.0 x 122.2 x 210.0 mm
