dueber-dev/SIMON-Sistema-de-Monitoreo-Neuronal/cad/caja_pcb/caja_simon_tapa_plano.SLDPRT

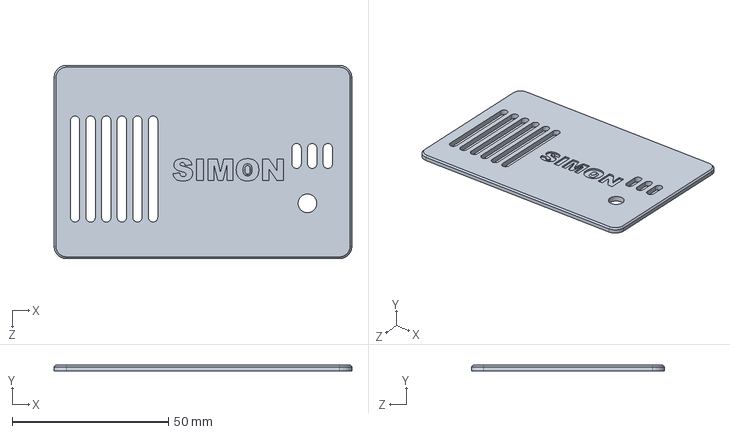
[picture p78: CAD file, 2026-10-27]
cad/caja_pcb/caja_simon_tapa_plano.SLDPRT
95.5 x 2.00 x 62.0 mm
