dueber-dev/SIMON-Sistema-de-Monitoreo-Neuronal/cad/modulo_panel/stl/buje.STL

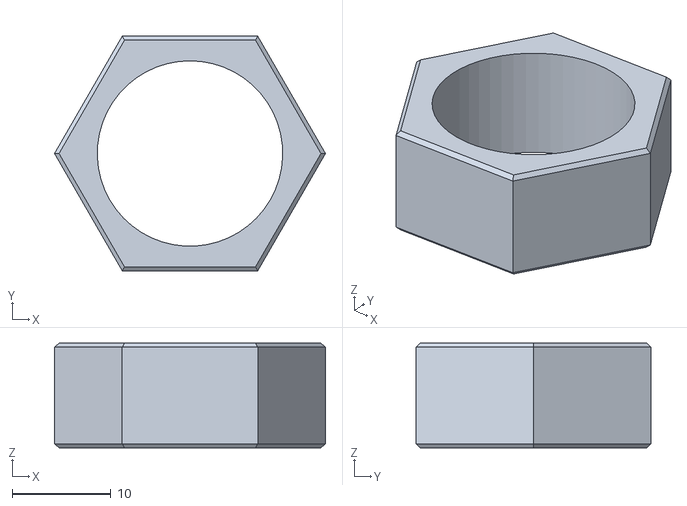
[picture p79: CAD file, 2026-10-27]
cad/modulo_panel/stl/buje.STL
27.5 x 23.8 x 10.6
