dueber-dev/SIMON-Sistema-de-Monitoreo-Neuronal/cad/solidworks/tapa_caja.SLDPRT

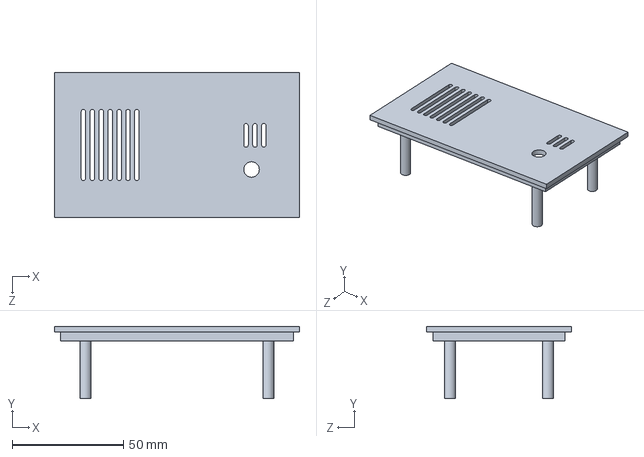
[picture p80: CAD file, 2026-10-27]
cad/solidworks/tapa_caja.SLDPRT
110.0 x 32.4 x 65.0 mm
