dueber-dev/SIMON-Sistema-de-Monitoreo-Neuronal/cad/modulo_panel/stl/tornillo.stl

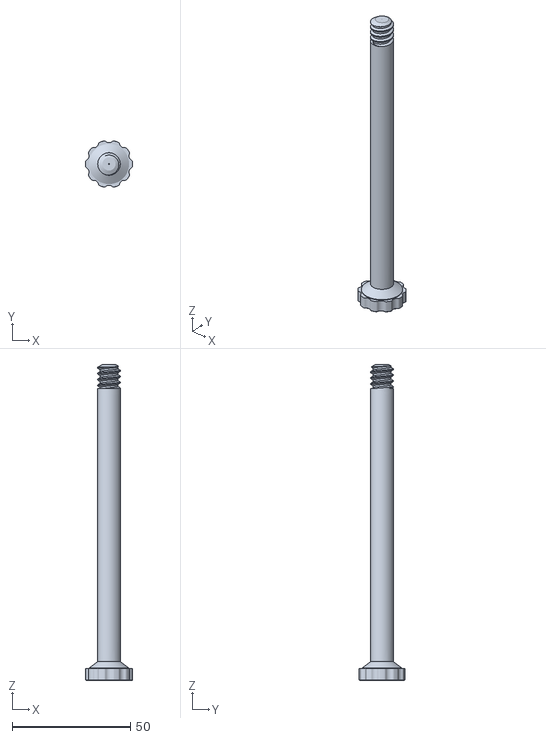
[picture p81: CAD file, 2026-10-27]
cad/modulo_panel/stl/tornillo.stl
20.0 x 19.5 x 133.8
