dueber-dev/SIMON-Sistema-de-Monitoreo-Neuronal/cad/solidworks/mastil_tubo.SLDPRT

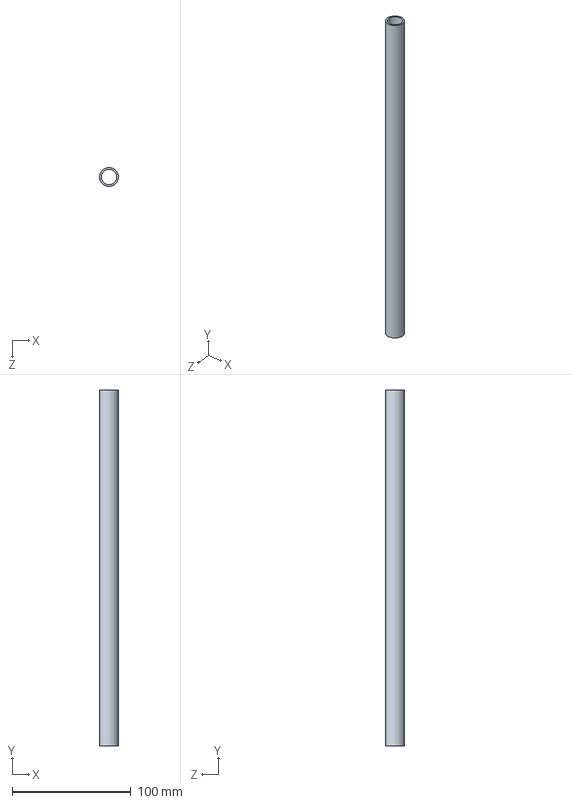
[picture p82: CAD file, 2026-10-27]
cad/solidworks/mastil_tubo.SLDPRT
15.9 x 300.0 x 16.0 mm
