dueber-dev/SIMON-Sistema-de-Monitoreo-Neuronal/cad/solidworks/ref_panel_solar.SLDPRT

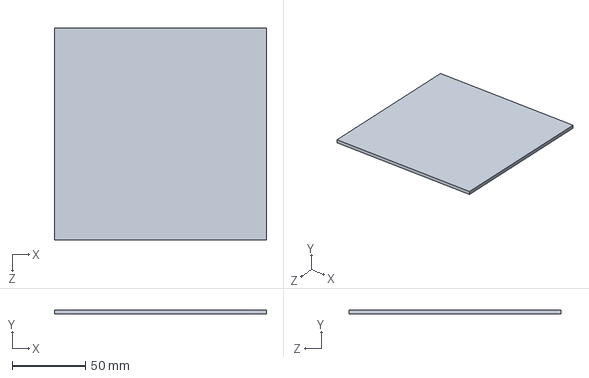
[picture p83: CAD file, 2026-10-27]
cad/solidworks/ref_panel_solar.SLDPRT
145.0 x 3.00 x 145.0 mm
