dueber-dev/SIMON-Sistema-de-Monitoreo-Neuronal/cad/solidworks/perilla_M4.SLDPRT

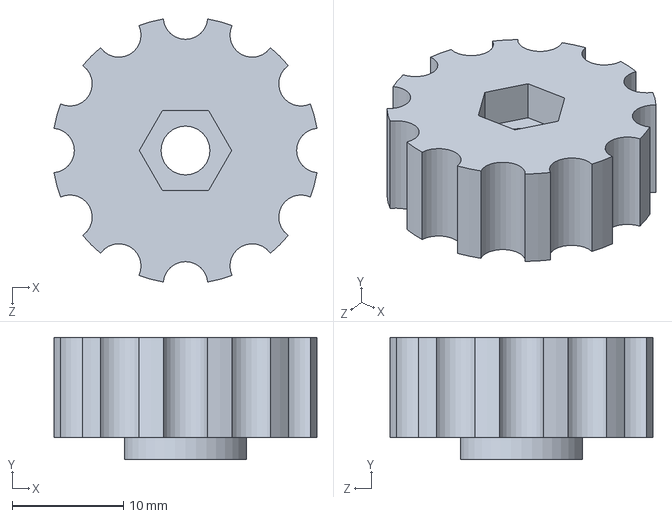
[picture p84: CAD file, 2026-10-27]
cad/solidworks/perilla_M4.SLDPRT
23.7 x 11.0 x 23.7 mm
