dueber-dev/SIMON-Sistema-de-Monitoreo-Neuronal/cad/solidworks/marco_panel.SLDPRT

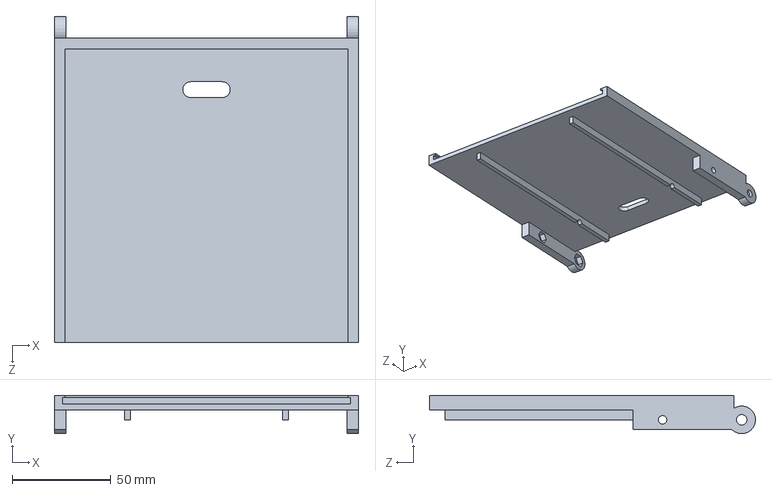
[picture p85: CAD file, 2026-10-27]
cad/solidworks/marco_panel.SLDPRT
153.8 x 19.4 x 164.8 mm
