dueber-dev/SIMON-Sistema-de-Monitoreo-Neuronal/(list of files, cad)

Other CAD files:
cad/turntable/stl/turntable_plato.STL
cad/turntable/stl/turntable_seguro.STL
cad/caja_pcb/caja_simon_base_plano.SLDPRT
cad/caja_pcb/caja_simon.SLDASM
cad/caja_pcb/stl/caja_simon_base.STL
cad/caja_pcb/stl/caja_simon_tapa.STL
cad/modulo_panel/originales/nut.stl
cad/modulo_panel/originales/tablet_bolt.stl
cad/modulo_panel/stl/camara_esp32.STL
cad/solidworks/SIMON_estacion.SLDASM
cad/stl/base_webcam.STL
cad/stl/base_y_torres.STL
cad/stl/brazo_camara.STL
cad/stl/caja_pcb.STL
cad/stl/marco_panel.STL
cad/stl/perilla_M4.STL
cad/stl/tapa_caja.STL
