dueber-dev/SIMON-Sistema-de-Monitoreo-Neuronal/cad/caja_pcb/capturas/ensamble_cerrado_plano.png

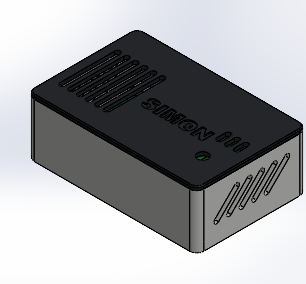
cad/caja_pcb/capturas/ensamble_cerrado_plano.png
