dueber-dev/SIMON-Sistema-de-Monitoreo-Neuronal/cad/caja_pcb/capturas/ensamble_trasera_usb_plano.png

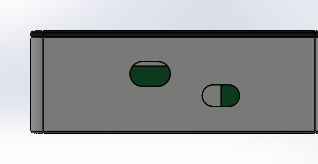
cad/caja_pcb/capturas/ensamble_trasera_usb_plano.png
