dueber-dev/SIMON-Sistema-de-Monitoreo-Neuronal/cad/capturas/ensamble_frente.png

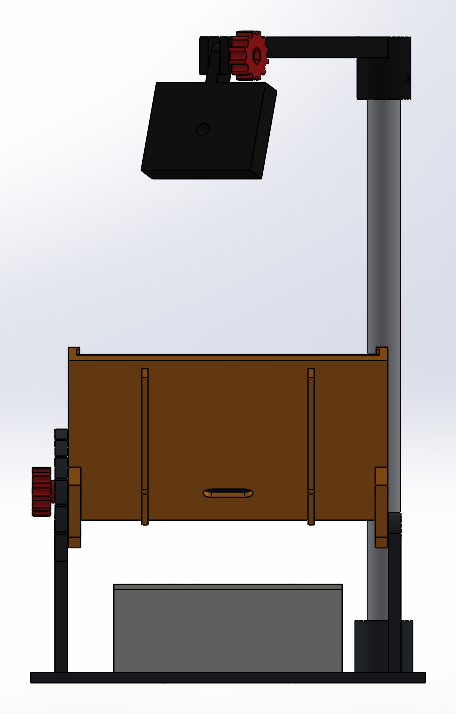
cad/capturas/ensamble_frente.png
