dueber-dev/SIMON-Sistema-de-Monitoreo-Neuronal/cad/capturas/ensamble_planta.png

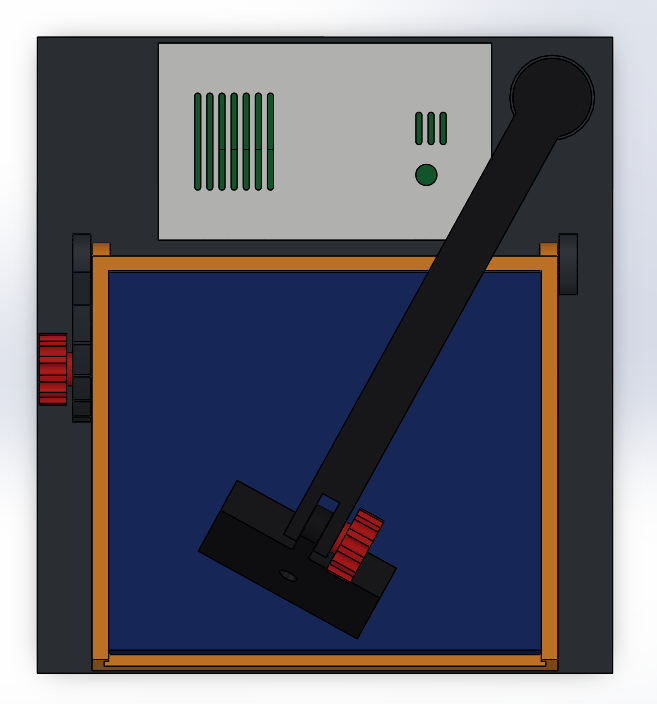
cad/capturas/ensamble_planta.png
