dueber-dev/SIMON-Sistema-de-Monitoreo-Neuronal/pcb/SIMON_montaje.pdf

## SIMON - guía de montaje (vista desde las piezas)

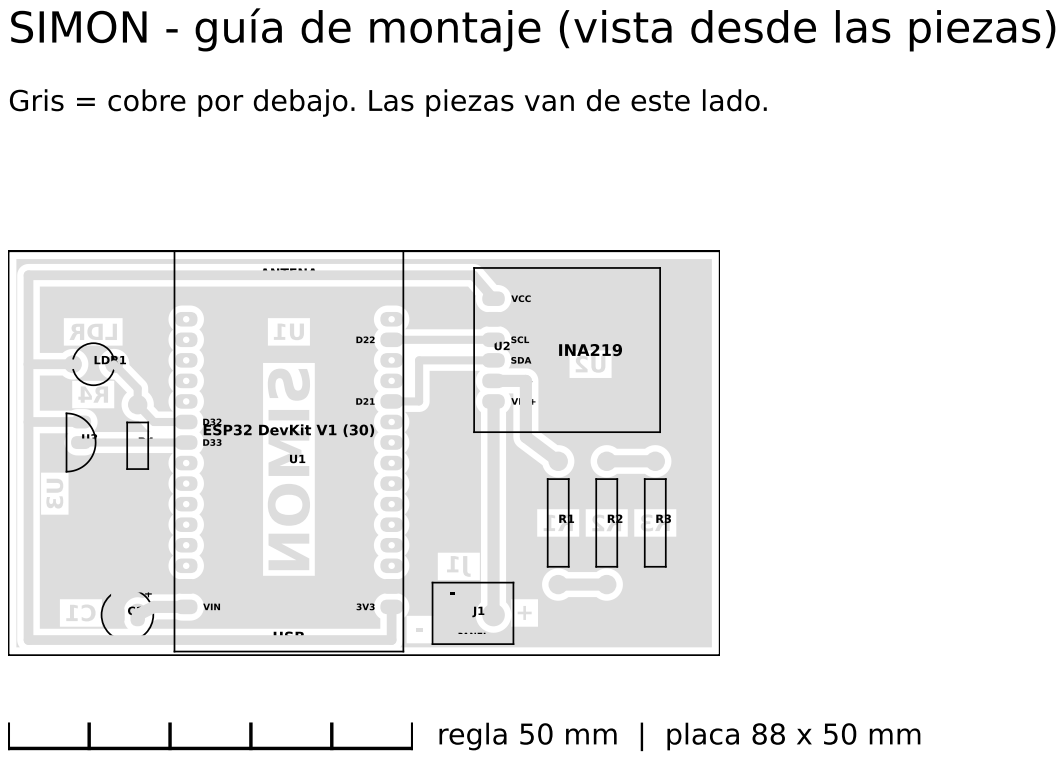
[picture p91: page 1]

Gris = cobre por debajo. Las piezas van de este lado.

regla 50 mm | placa 88 x 50 mm
