dueber-dev/SIMON-Sistema-de-Monitoreo-Neuronal/pcb/SIMON_cobre_1a1.pdf

## SIMON - capa BOTTOM (cobre) - lista para planchar

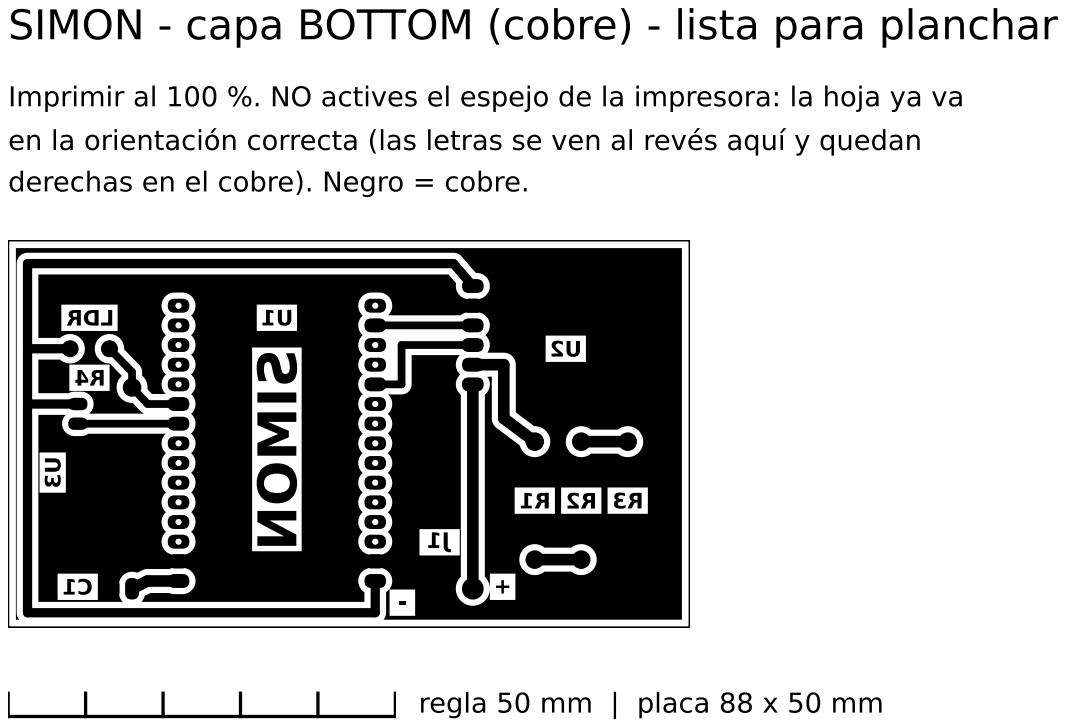
[picture p92: page 1]

Imprimir al 100 %. NO actives el espejo de la impresora: la hoja ya va
en la orientación correcta (las letras se ven al revés aquí y quedan
derechas en el cobre). Negro = cobre.

regla 50 mm | placa 88 x 50 mm
