dueber-dev/SIMON-Sistema-de-Monitoreo-Neuronal/(commit log)

2026-10-07 Agrega el prototipo original del monitor solar
    Firmware del ESP32 (INA219 + LM35 + LDR por TCP), cliente Python que
    guarda las lecturas en CSV y el dashboard de prueba en Streamlit. Se
    conservan tal cual como punto de partida y respaldo del rediseño.
2026-10-07 Agrega la maqueta del nuevo dashboard (vista En vivo)
    Maqueta estática con datos simulados para validar el look antes de
    programar la app real: tarjetas de vidrio sobre fondo personalizable,
    modo claro/oscuro y gráficas en SVG.
    La temperatura usa violeta en lugar de rojo porque el rojo no se
    distinguía del naranja de la potencia (validado para daltonismo).
    Voltaje y corriente van en gráficas separadas para evitar el doble eje.
2026-10-07 Completa las vistas de la barra lateral de la maqueta
    Agrega Análisis, Predicción ML, Sesiones y Configuración, navegables
    desde la barra lateral con un router por hash. Refs #1.
    La maqueta pasó de un solo HTML a módulos (simulador, gráficas,
    modelo demo, configuración y una vista por archivo) porque con cinco
    vistas el archivo único ya no era mantenible; además deja separada la
    lógica que luego se moverá a Astro y a FastAPI.
    La vista de Predicción usa un modelo de demostración (regresión
    polinómica entrenada en el navegador) para que las gráficas muestren
    datos con sentido hasta que exista el modelo del equipo. Se dice
    explícitamente en la vista para no confundirlo con el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
2026-10-09 Agrega eficiencia, umbrales de mantenimiento y justificación de indicadores
    Cubre lo que faltaba para el nivel Sobresaliente del criterio de diseño
    del dashboard en la rúbrica. Refs #2.
    La eficiencia real ahora es un indicador de primer nivel en En vivo y se
    compara contra la nominal de la ficha técnica. La alerta de mantenimiento
    usa la mediana de los últimos minutos y solo evalúa con buena luz: con el
    valor instantáneo cualquier nube o el atardecer la disparaban. La alerta
    de temperatura queda aparte porque el calor no se arregla limpiando.
    La irradiancia pasa a W/m² (estimada desde el LDR calibrado) para tener
    unidades físicas; el % crudo queda como dato secundario. Se agrega l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
2026-10-09 Documenta el diseño del dashboard y la justificación de indicadores
    Respaldo escrito para la presentación: usuario final, decisiones de
    diseño, por qué se eligió cada indicador, lógica de la alerta de
    mantenimiento, escenarios de prueba y su relación con la rúbrica.
    Refs #2.
2026-10-10 Agrega el documento de entrega con capturas y el dashboard en un solo archivo
    La profesora tiene que poder ver el dashboard en su computadora sin
    instalar Python ni levantar un servidor. La maqueta usa módulos ES e
    imágenes relativas, que el navegador bloquea al abrir un archivo local,
    así que se empaqueta todo (JS con esbuild, CSS y la foto) en un HTML.
    El documento de entrega incluye las capturas de todas las vistas, la
    relación con la rúbrica y el propio dashboard interactivo en base64,
    para que baste con entregar un solo archivo. Los scripts de tools/
    permiten regenerar todo cuando cambie el dashboard.
2026-10-19 Agrega la PCB de una cara para planchado (Fusion/EAGLE)
    La placa se genera desde un script en vez de dibujarse en Fusion porque
    agregar piezas de librería por comandos falla en Fusion Electronics
    (PlacePartWorker); el .brd generado se sube a Fusion tal cual.
    Huellas propias con pads grandes y pistas de 1.0-1.5 mm para que aguanten
    la transferencia de tóner. El negativo del panel se une a GND (en la hoja
    quedaba flotante) para que el INA219 pueda medir el voltaje del panel.
2026-10-19 Agrega relleno de GND y etiquetas en cobre a la PCB, al estilo de la U
    Así se hacen las placas en la universidad: casi todo el cobre queda como
    relleno de GND (menos ácido y menos tiempo de grabado) y cada pieza lleva su
    etiqueta en cobre dentro de un recuadro. Las etiquetas se ubican solas lejos
    de pistas y pads para no tener que reacomodarlas a mano cuando cambie la placa.
    El texto va espejado para leerse desde el lado del cobre; en la hoja impresa
    se ve al revés, y eso es lo correcto para la capa inferior.
2026-10-19 Engrosa las etiquetas en cobre y usa recortes del relleno
    Con la fuente vectorial de Fusion las etiquetas de 2 mm salían con trazo de
    0.36 mm, demasiado fino para la transferencia de tóner; al 31 % quedan en
    0.62 mm. Los recuadros pasan de bRestrict a recortes (cutout) del polígono:
    el restrict hacía que el DRC marcara cada texto como cobre en zona prohibida.
    Fusion queda con cero errores de DRC.
2026-10-26 Agrega la guía de montaje ilustrada de la PCB
    La guía 1:1 solo traía contornos de serigrafía y no dejaba claro qué pieza va
    en cada lugar ni su orientación. Esta imagen dibuja cada componente con su
    valor, la orientación del LM35, la polaridad de C1 y de la bornera, y los
    pines del ESP32 y del INA219 que se usan, junto con la lista de piezas.
2026-10-27 Agrega el CAD de la estación de inspección en SolidWorks
    Estación para el panel de 145 mm: base con torres de pivote, marco con
    inclinación 0-60° bloqueada por una perilla en una ranura en arco (híbrido
    entre el eje central y el riel del boceto: el eje aguanta el peso y el arco da
    el look de riel y marca el ángulo), caja ventilada para la PCB con ventana
    sobre la LDR, y mástil con brazo giratorio y base inclinable para la webcam.
    Se modela por la API COM de SolidWorks desde Python para que las piezas sean
    nativas (árbol de operaciones y croquis acotados) y se puedan regenerar al
    cambiar una medida; un STEP muerto no habría sido editable. La base de la
    webcam es genérica (clip de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
2026-10-27 Agrega la caja de la PCB con labio/escalón para imprimir
    Caja compacta alrededor del hueco de 90.5 x 52.5 que pidió el usuario (placa
    real + ~0.3 de tolerancia): las paredes ubican la placa, así que no hacen
    falta topes y se gasta menos filamento. Paredes de 2.5, piso y tapa de 2.0.
    El cierre es labio en la caja y escalón en la tapa, con 0.2 de holgura y
    anchos pensados en líneas de 0.42 para la boquilla de 0.4. La tapa se imprime
    con su cara plana en la cama y la caja con el piso abajo: ninguna lleva
    soportes. Alivios en las esquinas porque la impresora redondea las esquinas
    interiores y la PCB cuadrada se trabaría.
    La API de SolidWorks no expone la operación nativa Lip/Groove; por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
2026-10-27 Agrega rejilla de ventilación en el piso y más ranuras a la caja de la PCB
2026-10-27 Cambia las ranuras de ventilación de la base a diagonales de 45°
2026-10-27 Ensancha las ranuras de la base a 3 mm para que pase un jumper
2026-10-27 Quita los postes de la tapa de la caja de la PCB
2026-10-27 Agrega el turntable de Ø100 con clic cada 15° y seguro, en una pieza multicuerpo
2026-10-27 Ensancha las ranuras de la tapa a 3 mm
2026-10-27 Ensancha el interior de la caja a 57 mm hacia el USB y ajusta el labio
2026-10-27 Restaura la opción de introducir valor de cota al terminar los scripts
2026-10-27 Agrega el módulo del panel: soporte de la caja, bisagra con perilla y transportador
    El panel se inclina como en un phone holder: el tornillo de perilla que pasó German
    atraviesa dos torres y el tubo del marco, y al apretarlo el roce sostiene el ángulo
    (0 a 90°). El transportador va pegado al marco y el índice fijo en la torre, así el
    número que queda bajo el índice es la inclinación.
    - El soporte se ubica en el turntable con un buje hexagonal aparte (0.1 por lado en el
    plato): un pivote que saliera por abajo del soporte o por arriba del plato no se
    podría imprimir sin soportes. El plato del turntable gana ese hexágono.
    - El USB ya no baja por el centro: la base va plana sobre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
2026-10-28 Corrige las lecturas del firmware y agrega diagnóstico de sensores
    - Firmware: ya no recorta corrientes negativas, descarta lecturas I2C
    fallidas, lee el LM35 con analogReadMilliVolts y promedio recortado,
    calcula la potencia como V x I y arranca el Wi-Fi aunque falte el INA219.
    - diagnostico_sensores: imprime las lecturas crudas para compararlas
    con el multímetro y avisa de fallos de I2C, carga abierta o picos.
    - iniciar_dashboard.bat: abre el receptor TCP y Streamlit de un solo.
2026-10-28 Publica la dashboard en la nube con datos reales del ESP32
    - nube/: Worker de Cloudflare + D1. El ESP32 manda lotes de lecturas por
    POST con token y la dashboard las consulta (en vivo, sesiones y CSV).
    - design/: modo nube (nube.js) cuando se abre desde /simon; reemplaza al
    simulador con la sesión más reciente y las sesiones guardadas.
    - Firmware: se conecta al Wi-Fi de secrets.h y envía cada 5 s a la API;
    si no hay red, vuelve a crear su propia red como antes.
    - secrets.h (Wi-Fi y token) queda fuera del repo; plantilla en secrets.example.h.
2026-10-28 Muestra decimales en potencias pequeñas
    Bajo techo el panel genera centésimas de mW y con 0 decimales salía 0.
2026-10-28 Calcula la irradiancia con el panel y detecta suciedad comparándola con la LDR
2026-10-28 Agrega el documento del tercer avance en Word
2026-10-28 Actualiza el documento del avance 3: LDR y LM35 montados en el panel
2026-11-05 Guarda la versión del marco con el fondo abierto
    German le quitó el fondo al marco en SolidWorks (Cut-Extrude19 y 20): el
    panel queda sostenido solo por los labios. Esta copia es el estado antes de
    meterle el soporte de la cámara, por si hay que volver a ella.
2026-11-05 Agrega el soporte de la ESP32-CAM que se acopla al marco
    Pendiente del avance 3: fotos periódicas del panel para contrastar el índice
    de suciedad. El soporte va pegado al marco y no a la base, así gira con el
    panel: con el panel apuntado al sol la sombra cae fuera de él (aguanta ~21°
    de error) y el encuadre no cambia con la inclinación. Va del lado -X porque
    por el borde libre chocaría con la mesa a 90°. Es pieza aparte con clip para
    no reimprimir el marco y poder quitarla. Las medidas de la MB son supuestas.
2026-11-12 feat: integracion de camara de inspeccion visual ESP32-CAM (OV3660) con dashboard y endpoints en la nube
2026-11-12 Agrega sesiones programadas por horario en la dashboard
    El ESP32 se reinicia cuando el power bank lo corta y cada encendido abría una
    sesión nueva: una medición de una mañana quedaba partida en pedazos de 30 s.
    Ahora se programa una ventana (por ejemplo de 11:00 a 13:00) desde la vista
    Sesiones y todo lo que llegue en ese horario cae en la misma sesión, sin
    importar los reinicios. Fuera de una ventana todo sigue como antes.
    Al terminar una ventana, el mismo encendido abre una sesión nueva para no
    pegarle datos a la sesión que tenía antes de la ventana. La vista en vivo
    toma la última sesión que recibió datos, porque una programada se crea antes
    de tener lecturas. El CSV cuenta lo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
2026-11-12 Agrega el plan de recolección de datos y entrenamiento del modelo
    Define cuántos días y qué ventanas medir, la bitácora por sesión y cómo
    evaluar el modelo por días para que no memorice el conjunto de datos.
2026-11-12 docs: documentar arquitectura completa, configuracion de secrets.h, sensor OV3660 y despliegue en la nube
2026-11-12 Ajusta el plan de mediciones al 28 de noviembre con cupos por clima
    El equipo sale el 4 de diciembre y no hay tres semanas para medir. Como no
    se sabe qué clima va a tocar cada día, el plan pasa de un calendario fijo a
    cupos por condición (mínimo y ideal), con ventanas de 3 a 5 h. Incluye el
    cálculo de calor sobre el PETG y de autonomía del power bank para decidir si
    se pueden hacer sesiones largas, y descarta la pila de 9 V.
2026-11-12 config: cambiar intervalo de fotos a 3.5 minutos en ESP32-CAM
